Biskitman/Olympus-Rover/For Meeting/CAD/Rover_SomePanelsGone.PNG

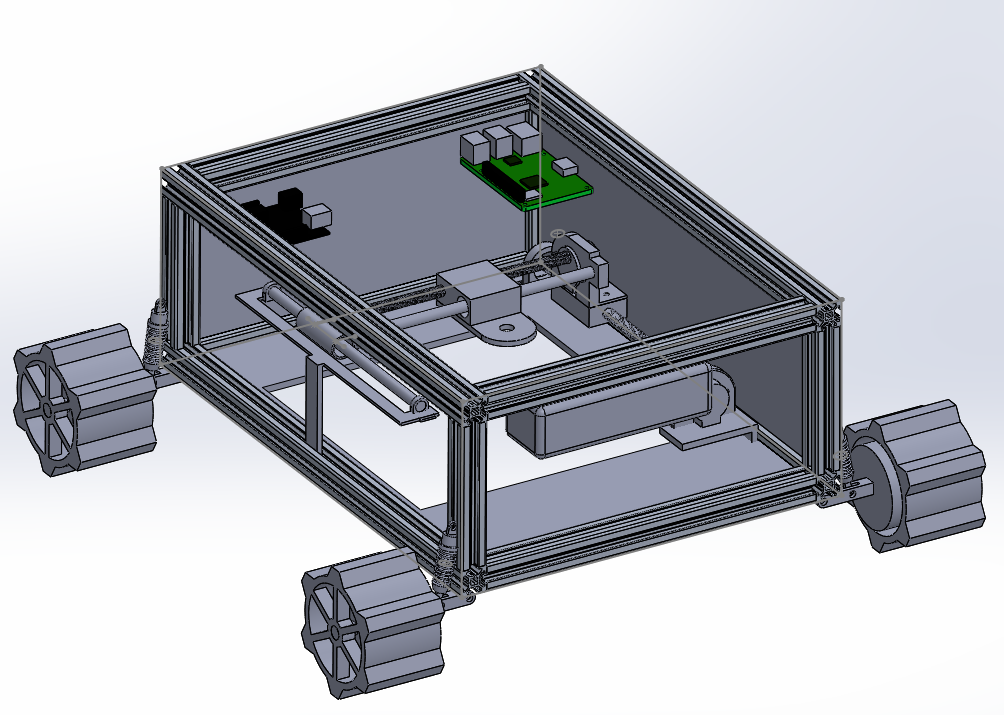
For Meeting/CAD/Rover_SomePanelsGone.PNG
