Biskitman/Olympus-Rover/README.md

# Olympus-Rover
Astro Society - Project Olympus Rover 2020 by UKSEDS
