Biskitman/Olympus-Rover/'Research Work'/Rover Suspension System.docx

Rover suspension system

In order to guarantee the best performances and to avoid any damage to the internal parts or to a hypothetic load, it’s important to design a very good suspension system for the rover. The rover will have 6 wheels and everyone of those will be directly connected to the chassis through a shock absorber. The distance between the shock absorbers will be fixed on one end of the body, whereas, on the other it will be adjustable so that we can set the tracks at the right tension. As we don’t know what the final weight of the whole system will be, we will be using adjustable shock absorbers. That will allow us to modify the length of the springs and consequently the thrust produced following Hooke’s law: F= -kX

Where k is the spring constant which remains the same, and X is the displacement of the spring. As we can see the force produced is proportional to the extension, so, if we modify the last one, we can get the right force for our system (Matt Williams, 2015).

In conclusion these are the shock absorbers, we need 3 sets of them (6 in total): https://www.amazon.co.uk/BQLZR-Purple-108004-RC1-Suspension/dp/B00RSY6G36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

References

Matt Williams (2015) What is Hooke’s Law?. Available at: https://phys.org/news/2015-02-law.html (Accessed: 12 February 2020).
