Biskitman/Olympus-Rover/'Research Work'/Wheels vs Tracks.docx

Wheels vs Tracks

The team looked at different wheel types and methods for motion across all terrains and decided to look at the benefits of using tracks over wheels. The ideal system is reliant on the terrain type, weight, the needed traction, and controllability. Tracks are suitable for soft surfaces due to their lower pressure and for driving over obstacles. They enable greater power efficiency, which is extremely important for the limited power supply that our rover has. On the other hand, wheels have greater simplicity and less moving parts, lighter weight and greater maneuverability (Wheels vs Continuous Tracks: Advantages and Disadvantages 2015).

According to Wheels vs Tracks from the journal of terramechanics, “On a firm sandy (or frictional) soil, the traction of a wheeled vehicle is less dependent on tire contact area. Therefore, the traction of a wheeled vehicle is closer to that of a comparable tracked vehicle on a firm sandy (or frictional) soil than on a clayey (or cohesive) soil.” (J.Y Wong, Wei Huang, 2006), this is important given the terrain details given for the competition being Mars analogue, and clay like.

The power efficiency of wheels vs tracks are also pointed out from the journal, when it’s stated that “the thrust developed by the 8 × 8 wheeled vehicle is 50.4% of that developed by the tracked vehicle. The lower thrust of the 8 × 8 wheeled vehicle, in comparison with the comparable tracked vehicle, is primarily due to the fact that with a much shorter contact length, the shear displacement at the rear of the contact patch of a tire will be much lower than that of a track at the same slip. Since the thrust developed by a vehicle running gear is the integration of the shear stress over the contact area, with lower shear stress and lower contact area, the thrust developed by a wheeled vehicle will generally be lower than that developed by a comparable tracked vehicle.” (J.Y Wong, Wei Huang, 2006) This is important given the limited power supply in our design, and as a result efficiency is of great importance.

The team has decided that with our design, a few key things are important with movement, efficiency, controllability and the ability to climb over obstacles. It is for this reason that we’ve concluded that the pros of using continuous tracks outweigh the cons given the requirements and limitations.

References

i. J.Y Wong, Wei Huang, (2006) ‘Wheels vs. tracks – A fundamental evaluation from the traction perspective’, Journal of Terramechanics (https://www-sciencedirect-com.ezproxy.kingston.ac.uk/science/journal/00224898), 43,1, pp. 27-43, Available at: https://www-sciencedirect-com.ezproxy.kingston.ac.uk/science/article/pii/S0022489804000886#bib2 (Accessed: 9th February 2020)
ii. Wheels vs Continuous Tracks: Advantages and Disadvantages (2015) Available at: https://www.intorobotics.com/wheels-vs-continuous-tracks-advantages-disadvantages/ (Accessed: 12th February 2020)
