Biskitman/Olympus-Rover/Reports/CDR/scedule.xlsx

Sheet: Planned CDR Schedule
 |  | PDR due 20th |  |  |  |  |  |  |  |  |  | CDR due 1st
 | Date | DEC 16th | DEC 23rd | DEC 30th | JAN 6th | JAN 13th | JAN 20th | JAN 27th *** | FEB 3rd | FEB 10th | FEB 17th **** | FEB 24th ** | MAR 2nd | MAR 9th | MAR 16th | MAR 23rd | MAR 30th
Person
Iras |  |  | HOLIDAY |  |  |  | Seek Funding & University Materials |  | Find and compile part spreadsheet of Parts to Buy |  | Write CDR |  | TO BE SCHEDULED
Erika |  |  |  |  |  |  | Risk assesment & Lab application |  |  | Create Post-CDR Schedule
Nikolo |  |  |  |  |  |  | Researching & Choosing Materials & Processes to Use |  |  | Basic Prototyping |  | Help CDR
Bertie |  |  |  |  |  |  | Engineering Drawing & 3D Modelling |  |  |  | Help CDR
Sam |  |  |  |  |  |  | Research & Choose Electronics to Use |  | Power Calculations | Circuit Diagrams & Basic Prototypes if Possible |  | Help CDR
Emily |  |  |  |  |  |  |  |  | Choose Languages/Platforms & do Initial Code Plan |  |  | Help CDR
The roles we had allocated from the beginning of the project lent itself well into dividing the team into pairs to work on 3 categories of tasks together: Design (Bertie & Nikolo), Admin (Iras & Erika) and Electronics (Sam & Emily) tasks. We had a rough week-by-week schedule of tasks for each person, up to the CDR submission date, and had planned to make a new schedule for after the CDR up to the Readiness Review, however, due to disruptions in the team, this did not happen.
1. For the last week before the CDR submission deadline, everyone was intended to work on the CDR as a sort of mitigation to ensure that the CDR is definitely complete on time, in case the workload of writing the CDR was too difficult for just two people and the CDR needed extra work. We do admit that this was not enough time dedicated to margin/mitigation time, as many things did go wrong and we did not complete all that we intended to before the CDR submission date and therefore have included much more margin time in our post-CDR schedule as a result.
2. Erika drops out |  |  | 3. By this time, members who hadn't held up to their roles either willfully left the team or were kicked out. This was decided to be the best course of action as we could make a new schedule around reliable members of the team only, giving us a reduced risk of delays in the future. However, with only two real team members remaining and most tasks being incomplete, we had to prioritise tasks dependant on how urgantly they needed to be completed and so focussed our attention on the CDR and all tasks crucial to the CDR submission. Unfortunately due to this constraint, we have decided to postpone the following tasks to be completed after the CDR submission: Aquiring funding & university funding, 3D modelling, Prototyping and Completing full risk assesments & lab packs to gain access to university manufacturing facilities.

Sheet: Planned Post-CDR Schedule
 |  | CDR due 1st |  |  |  |  |  |  | CDR Interview 14th |  |  |  |  |  |  | TRR due 1st
 |  | Date | MAR 2nd | MAR 9th | MAR 16th | MAR 23rd | MAR 30th | APR 6th | APR 13th | APR 20th | APR 27th | MAY 4th | MAY 11th | MAY 18th | MAY 25th | JUN 1st | JUN 8th | JUN 15th | JUN 29th | JUL 6th | JUL 13TH | JUL 20th | JUL 27th | APR 3rd
Task # | Task Name
1.00 | ADMIN TASKS
1.10 | Organise Funding
1.11 | Write up official description + part list
1.12 | Start a KU backer campaign
1.13 | Contact student union about funding
1.14 | Talk to society treasurer about using a portion of monthly society funds
1.15 | Contact possible investors
1.20 | Procure materials/parts
1.21 | Request spare available materials from construction labs
1.22 | Order parts from uni suppliers through lab technicians
1.23 | Order rest of parts privately to project leaders house
1.24 | Receive all parts and reorder/refund any that do not arrive on time
1.30 | Access construction facillities
1.31 | Perform a risk assesment
1.32 | Ensure all members have completed compulsory saftey training
1.33 | Organise dates to use construction labs
1.40 | Prepare for readiness review
1.41 | Film progress video
1.42 | Keep logbook of progress
2.00 | MANUFACTURING TASKS
2.10 | 3D Modelling parts
2.11 | Chassis
2.12 | Crane system
2.13 | Tracks
2.14 | Suspension
2.15 | Vibration plate interface
2.16 | Electronics
2.17 | Compile all together
2.20 | Constructing
2.21 | Chassis
2.22 | Crane system
2.23 | Tracks
2.24 | Suspension
2.25 | Vibration plate interface
2.26 | Electronics
2.27 | Compile all together + tweak
3.00 | PROGRAMMING / ELECTRONICS
4.00 | TESTING

Sheet: Trade-Offs
Trade-Offs
 | Ease to Implement | Weight | Price Effectiveness | Weight | Durability | Weight | Time Effectiveness | Weight | Weather Resistance | Weight | Grip | Weight | Total
Wheels
Tracks
Legs
Omniwheels
 | Ease to Implement | Weight | Price Effectiveness | Weight | Durability | Weight | Time Effectiveness | Weight | Reliability | Weight | Total
Bought Suspension
Custom Design
Springs
None
 | Ease to Implement | Weight | Price Effectiveness | Weight | Reliability | Weight | Time Effectiveness | Weight | Range | Weight | Speed | Weight | Bandwidth | Weight | Total
Radio
Bluetooth
Wifi
 | Ease to Implement | Weight | Price Effectiveness | Weight | Durability | Weight | Time Effectiveness | Weight | Reliability | Weight | Total
Dual Axis Crane
Robot Arm
Scoop

Sheet: Sheet5
 |  | Selection Criteria - Movement System
 | Weight % | Wheels (Reference) | Weighted | Tracks | Weighted | Legs | Weighted | Omniwheels | Weighted
Ease to Implement | 15 | 3 | 0.45 | 2 | 0.3 | 1 | 0.15 | 1 | 0.15
Price | 10 | 3 | 0.3 | 2 | 0.2 | 3 | 0.3 | 1 | 0.1
Durability | 25 | 3 | 0.75 | 2 | 0.5 | 2 | 0.5 | 2 | 0.5
Time Effectiveness | 10 | 3 | 0.3 | 2 | 0.2 | 3 | 0.3 | 2 | 0.2
Environment Resistance | 20 | 3 | 0.6 | 4 | 0.8 | 4 | 0.8 | 2 | 0.4
Grip | 20 | 3 | 0.6 | 5 | 1 | 1 | 0.2 | 2 | 0.4
Total Weighting | 100
Total Score |  | 3 |  | 3 |  | 2.25 |  | 1.75
Rank |  | First |  | First |  | Second |  | Third
Continue? |  | Consider |  | Consider |  | No |  | No
 |  | Selection Criteria - Suspension
 | Weight % | Bought Suspension (Ref) | Weighted | Custom Design | Weighted | Springs | Weighted
Ease to Implement | 10 | 3 | 0.3 | 1 | 0.1 | 3 | 0.3
Price | 5 | 3 | 0.15 | 3 | 0.15 | 4 | 0.2
Durability | 15 | 3 | 0.45 | 2 | 0.3 | 4 | 0.6
Time Effectiveness | 5 | 3 | 0.15 | 1 | 0.05 | 2 | 0.1
Reliability | 25 | 3 | 0.75 | 2 | 0.5 | 2 | 0.5
Shock Absorbtion | 40 | 3 | 1.2 | 2 | 0.8 | 2 | 0.8
Total Weighting | 100
Total Score |  | 3 |  | 1.9 |  | 2.5
Rank |  | First |  | Third |  | Second
Continue? |  | Yes |  | No |  | No
 |  | Selection Criteria - Communication
 | Weight % | Radio (Ref) | Weighted | Wifi | Weighted | Bluetooth | Weighted
Ease to Implement | 10 | 3 | 0.3 | 4 | 0.4 | 4 | 0.4
Price | 10 | 3 | 0.3 | 5 | 0.5 | 5 | 0.5
Reliability | 25 | 3 | 0.75 | 4 | 1 | 3 | 0.75
Time Effectiveness | 5 | 3 | 0.15 | 4 | 0.2 | 5 | 0.25
Range | 20 | 3 | 0.6 | 3 | 0.6 | 2 | 0.4
Speed | 15 | 3 | 0.45 | 4 | 0.6 | 2 | 0.3
Bandwidth | 15 | 3 | 0.45 | 5 | 0.75 | 3 | 0.45
Total Weighting | 100
Total Score |  | 3 |  | 4.05 |  | 3.05
Rank |  | Third |  | First |  | Second
Continue? |  | No |  | Yes |  | As a backup system
 |  | Selection Criteria - Method of Pickup
 | Weight % | Robot Arm (Ref) | Weighted | Dual Axis Crane | Weighted | Scoop | Weighted
Ease to Implement | 10 | 3 | 0.3 | 1 | 0.1 | 4 | 0.4
Price | 5 | 3 | 0.15 | 3 | 0.15 | 4 | 0.2
Durability | 15 | 3 | 0.45 | 4 | 0.6 | 5 | 0.75
Time Effectiveness | 5 | 3 | 0.15 | 3 | 0.15 | 4 | 0.2
Reliability | 25 | 3 | 0.75 | 4 | 1 | 2 | 0.5
Precision | 40 | 3 | 1.2 | 5 | 2 | 1 | 0.4
Total Weighting | 100
Total Score |  | 3 |  | 4 |  | 2.45
Rank |  | Second |  | First |  | Third
Continue? |  | No |  | Yes |  | No
