Biskitman/Olympus-Rover/For Meeting/CAD/Crane.PNG

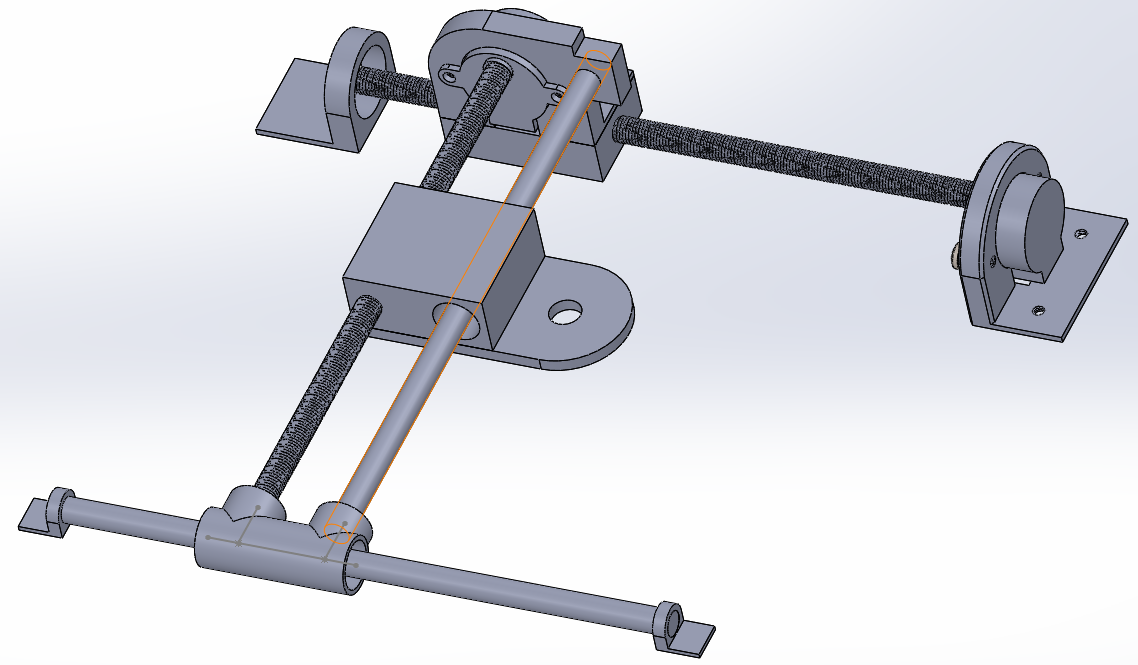
For Meeting/CAD/Crane.PNG
