Biskitman/Olympus-Rover/For Meeting/CAD/Rover_AllPanels.PNG

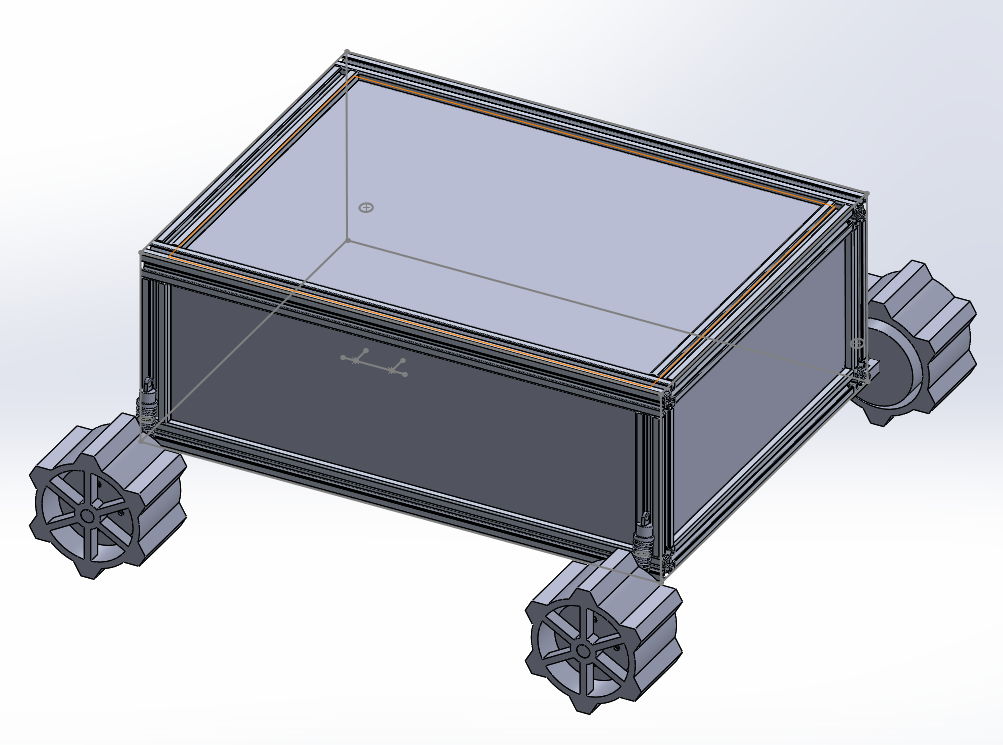
For Meeting/CAD/Rover_AllPanels.PNG
