Biskitman/Olympus-Rover/For Meeting/CAD/Rover_Open.PNG

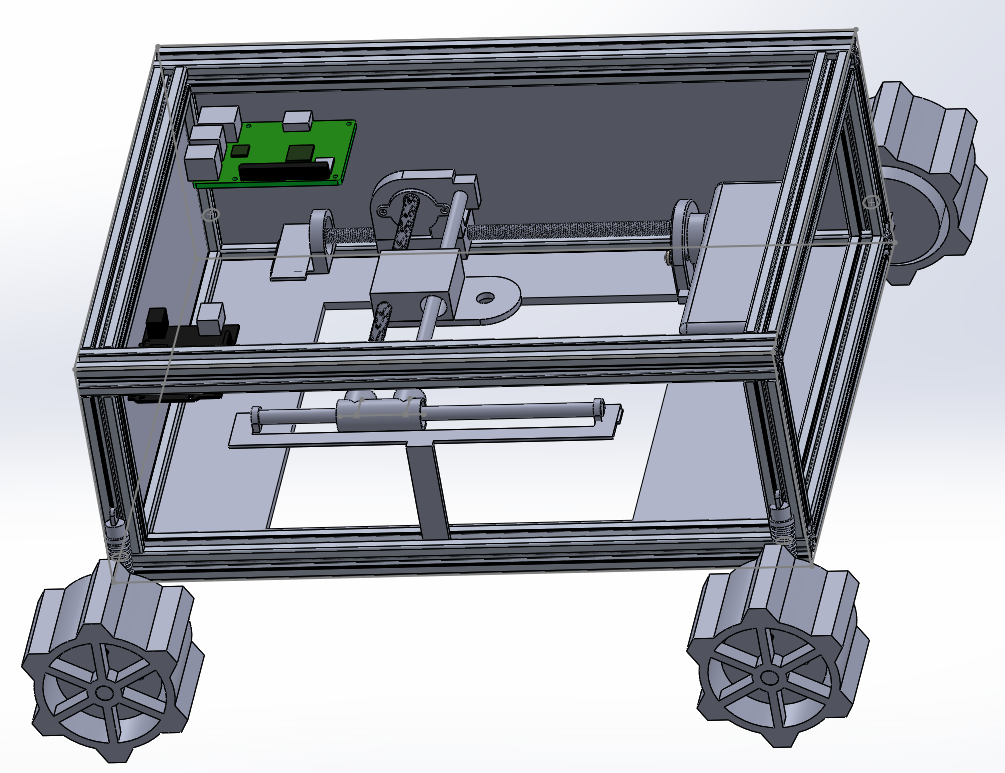
For Meeting/CAD/Rover_Open.PNG
