Biskitman/Olympus-Rover/For Meeting/CAD/Rover_Top_Off.PNG

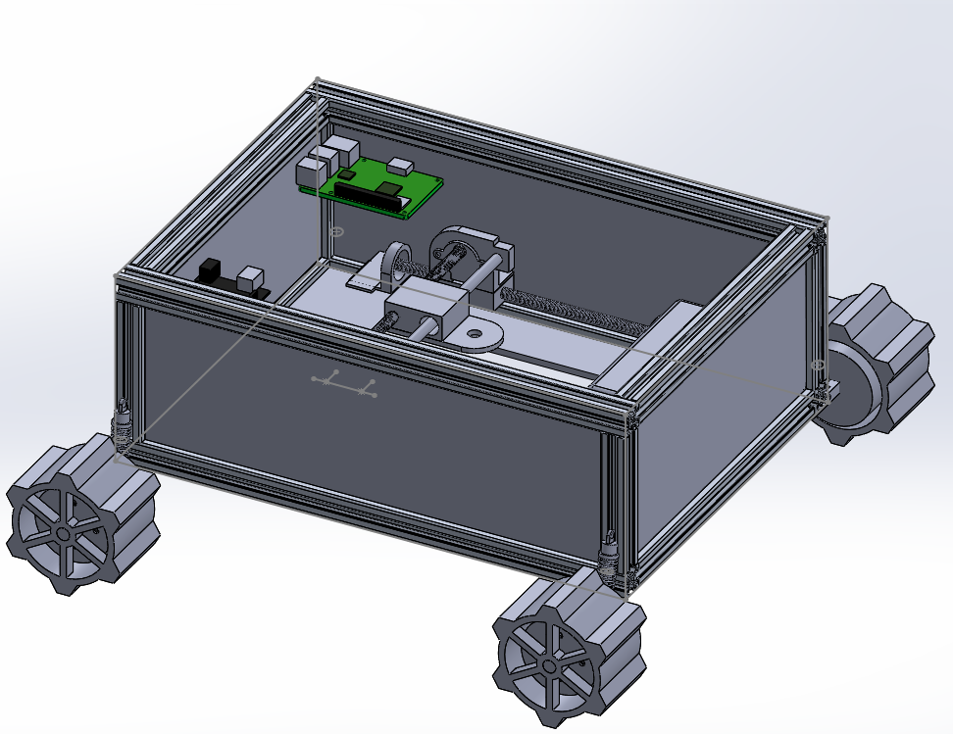
For Meeting/CAD/Rover_Top_Off.PNG
