Biskitman/Olympus-Rover/For Meeting/CAD/Vibration_Interface.PNG

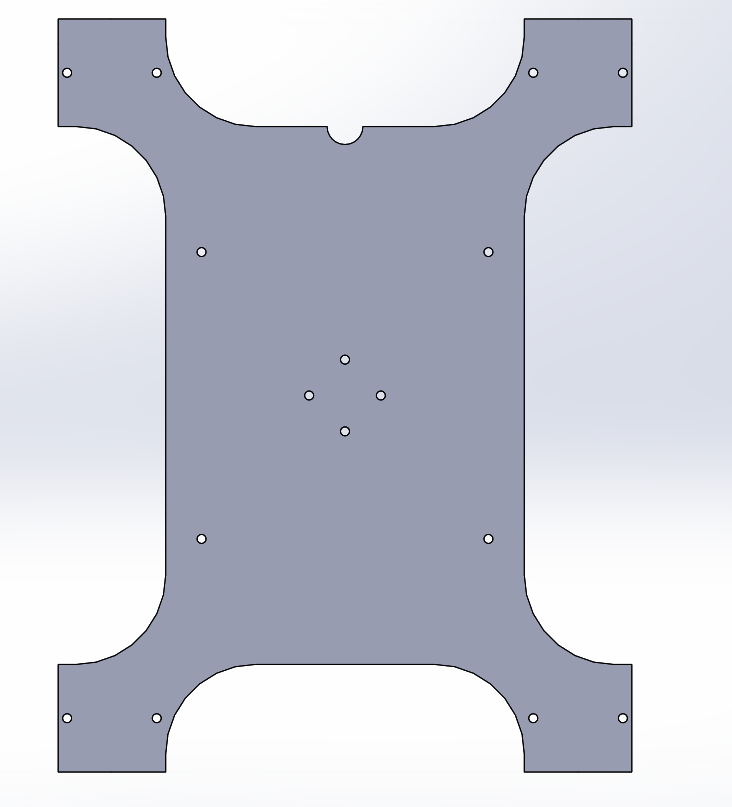
For Meeting/CAD/Vibration_Interface.PNG
