Biskitman/Olympus-Rover/Pictures/Caterpiller Tracks.png

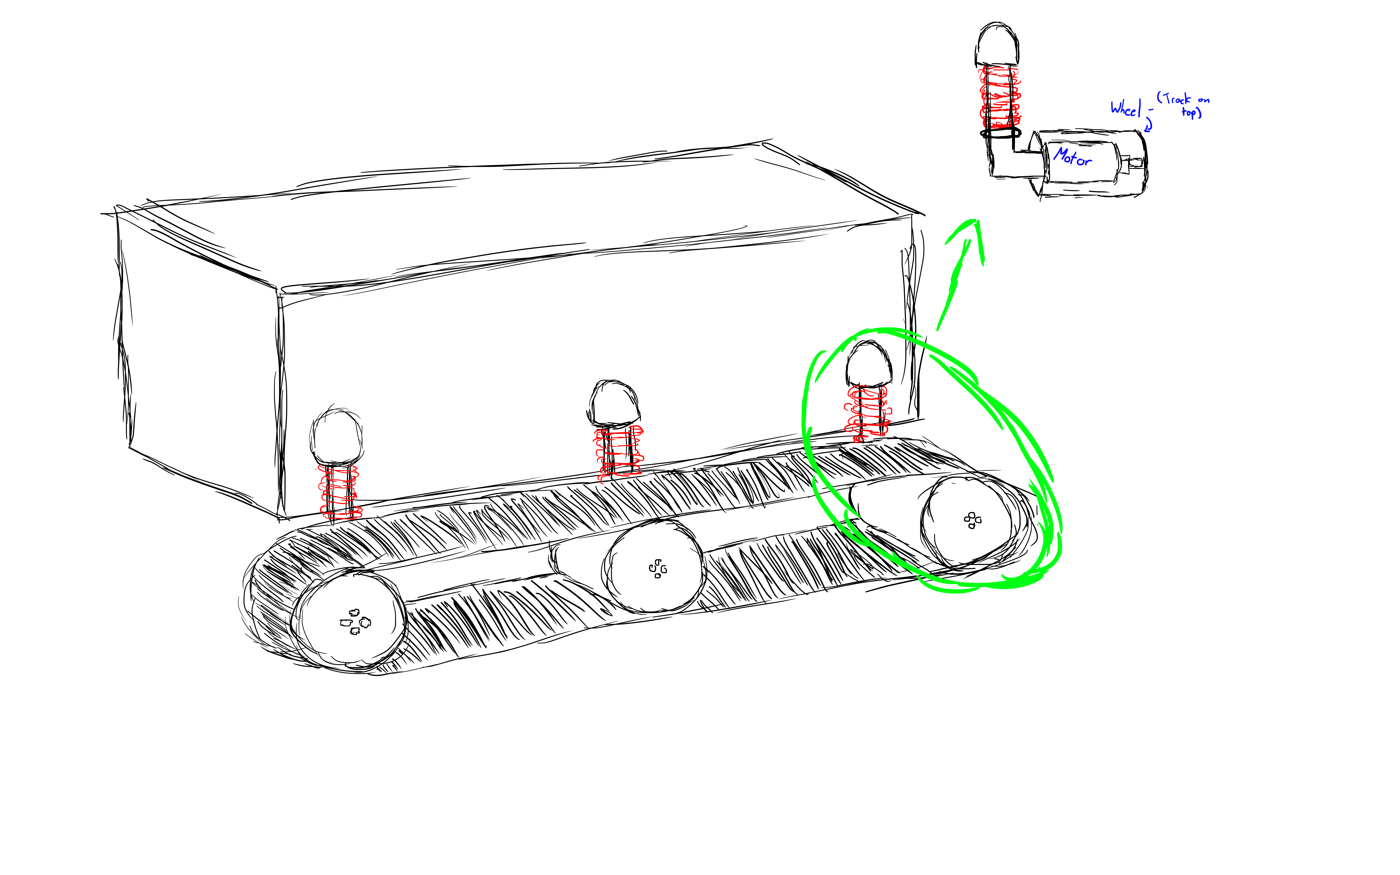
Pictures/Caterpiller Tracks.png
