Biskitman/Olympus-Rover/Pictures/Rover Overview (OG).png

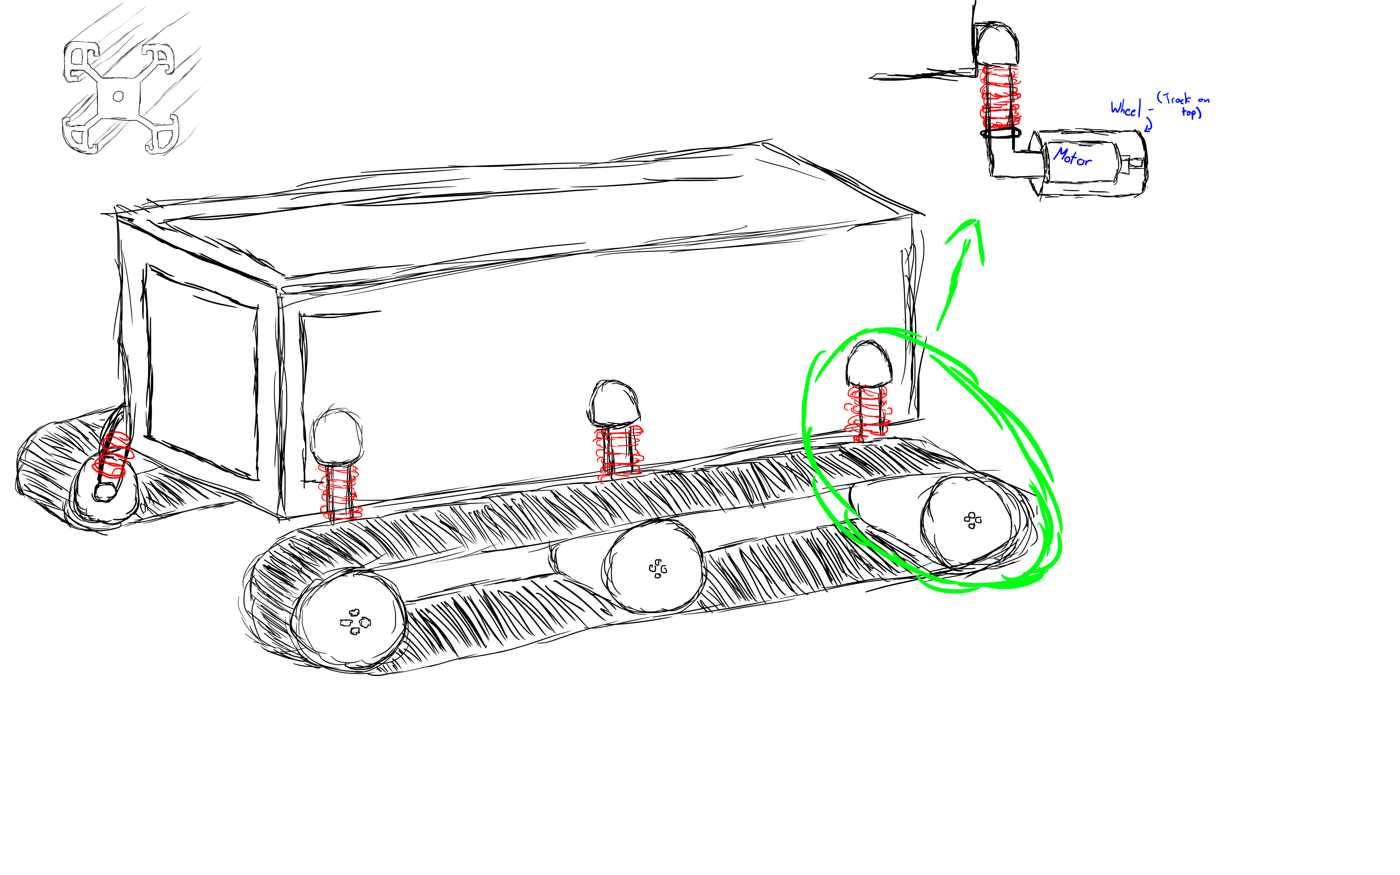
Pictures/Rover Overview (OG).png
