Biskitman/Olympus-Rover/Pictures/Suspension.PNG

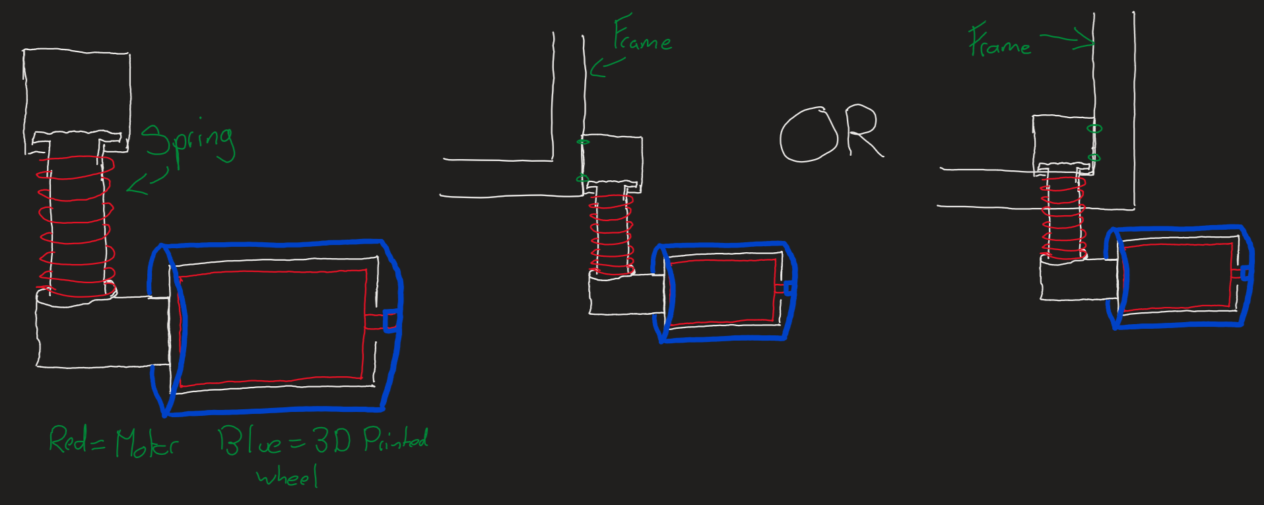
Pictures/Suspension.PNG
