Biskitman/Olympus-Rover/Pictures/Top Down, Electronics.png

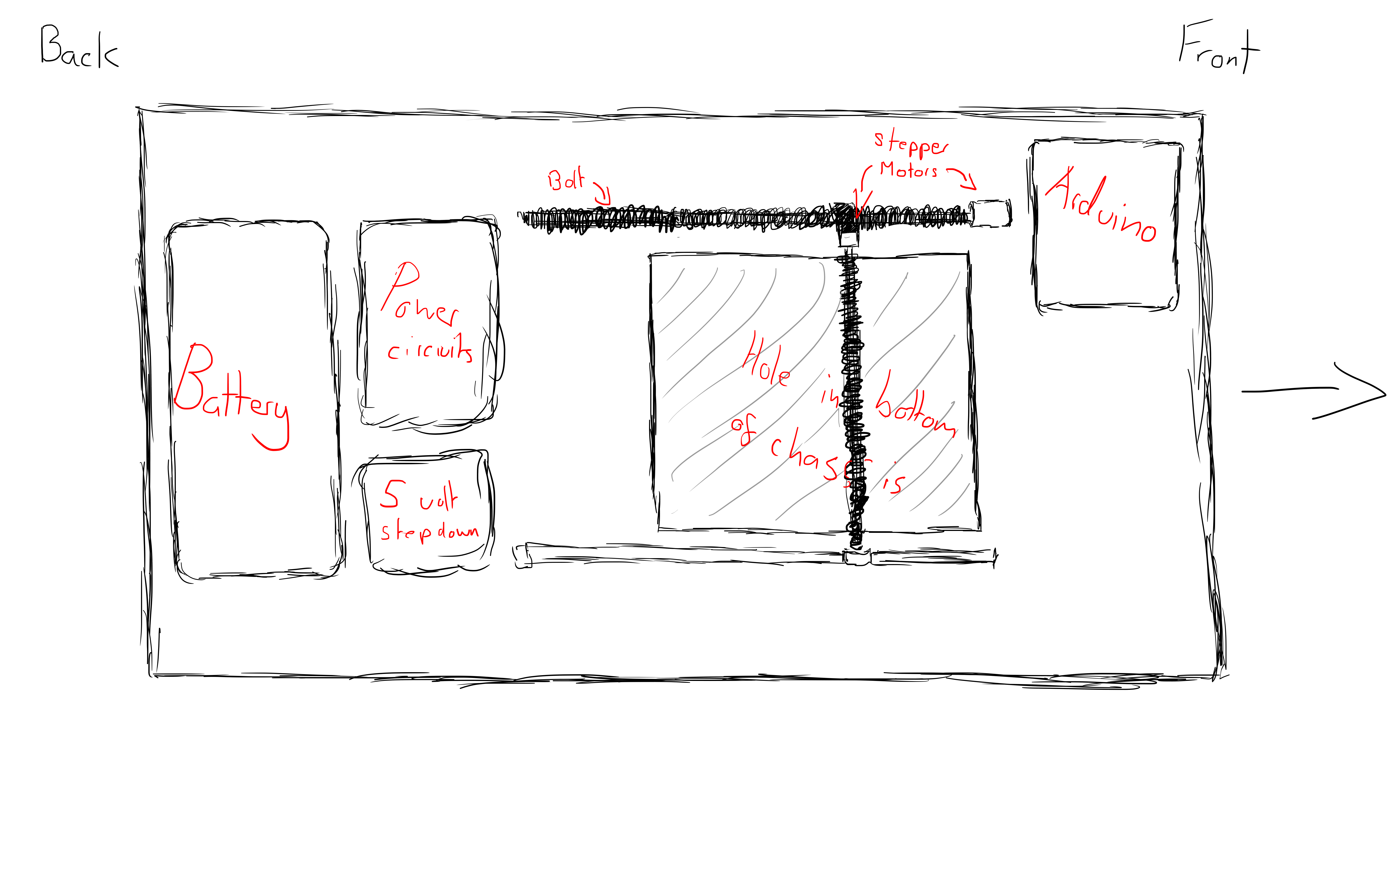
Pictures/Top Down, Electronics.png
