Biskitman/Olympus-Rover/Reports/CDR/Rover part list.xlsx

Sheet: Sheet1
Part | Price | Amount Needed | Total | Link | Purpose & Justification
Raspberry Pi 4 (4GB model B) | £54.00 | 1 | £54.00 | https://thepihut.com/products/raspberry-pi-4-model-b?variant=20064052740158&src=raspberrypi | The Raspberry Pi 4 is the latest and most powerful raspberry pi with integrated wifi. This model will be powerful enough to manage the networking and machine learning we would like to integrate onto the rover, and is capable of running high
Arduino Nano 33 BLE Module | £21.06 | 1 | £21.06 | https://uk.rs-online.com/web/p/processor-microcontroller-development-kits/1927587/ | The small form factor and 9-axis intertial sensor on this board is perfect for our project as we have limited space and will need the rover to remain stable. It still has all the pins of a regular-sized arduino and does not require a wifi module as this will be handled by the raspberry pi.
Small breadboards (option 1) | £5.99 | 2 | £11.98 | https://www.amazon.co.uk/ELEGOO-tie-points-Breadboard-Breadboards-Electronic/dp/B01N0YWIR7 | Space is very limited in this project and we do not require many pins for the extra coponents that will need to connect to the arduino. The size of these also allow us to adjust the spacing of the electronics around the other parts of the rover where position is more fixed. One breadboard will be used for the motors, and one for the sensors. (In the final rover we can solder the components but for prototyping, the breadboards are more suitable)
Small breadboards (option 2) | £5.15 | 2 | £10.30 | https://uk.rs-online.com/web/p/breadboards/6348875/ | Thin version from RS components, for advantages, see above.
Jumper wires | £5.95 | 1 | £5.95 | https://www.amazon.co.uk/Elegoo-120pcs-Multicolored-Breadboard-arduino-colorful/dp/B01EV70C78 | Good variety of different wires to use for attatching components within the prototype.
Battery | £49.99 | 1 | £49.99 | https://www.amazon.co.uk/FCONEGY-11-1V-5500mah-Battery-Deans/dp/B07PHST8C3
Motors | £7.99 | 4 | £31.96 | https://www.amazon.co.uk/EsportsMJJ-Teeth-Electric-Motor-Bosch/dp/B075CN3MDL?s=home-garden
Stepper Motors | £11.58 | 1 | £11.58 | https://www.amazon.co.uk/Kuman-Stepper-arduino-28BYJ-48-Breadboard/dp/B01IP7IOGQ
Tracks | £11.13 | 1 | £11.13 | https://www.amazon.co.uk/Baosity-Plastic-Removable-Tracked-Chassis/dp/B07R4GQ32N
Suspension systems |  |  | £0.00
Cameras | £24.00 | 2 | £48.00 | https://thepihut.com/products/raspberry-pi-camera-module?src=raspberrypi | Only raspberry pi camera module suitable for livestreaming over wifi due to fast operation and 1080p quality at 30hz with an 8megapixel sensor. Has official raspberry pi camera ribbon connector and support in raspbian, making it easy to use and program with.
ultrasonic sensors | £8.99 | 3 | £26.97 | https://www.amazon.co.uk/ELEGOO-Ultrasonic-Raspberry-Datasheet-Available/dp/B01M0QL1F1
Claw | £13.39 | 1 | £13.39 | https://www.aliexpress.com/item/32860356446.html?spm=a2g0o.productlist.0.0.53a45679fCa5el
Total | £219.22 |  | £296.31
Weights | Max
Battery | 1kg
Motors | 1 for 250, max weight 1kg
pi + ardu | 60g
tank treads | unlisted, negligable
aluminium extrusion | 20 x 20, 0.5kg per m | 1kg

Sheet: Sheet2
 | Weeks | March 2th - 8th | 9th - 15th | 16th - 22nd | 23rd - 29th | 30th - April 5th | 6th - 12th | 13th - 19th | 20th - 26th | 27th - May 3rd | 4th - 10th | 11th - 17th | 18th - 24th | 25th - 31st | June 1st - 7th | 8th - 14th | 15th - 21st | 29th - July 5th
Key Dates |  |  |  |  |  | March 31st RID & presentation |  |  |  | May - Close outstanding RIDs |  |  |  |  | June - TRR & Video
Activity
Raise Funds
Order & Test Parts
Reorder Faulty parts
Planning code/ modeling
Construction
Physical/Durability Testing
Programming
Program/Movement Testing
Training/Further Testing
Calibration/Tweaking
Preparing For RID
Preperation of TRR
Final Prep for Event
Key
Admin Activities
Production
Testing
Mitigation Time
