Biskitman/Olympus-Rover/Reports/CDR/Final Submission/Team Ares RIDs Feedback 2019_2020.xlsx

Sheet: RID Marksheet
RID# Reference | Document | Page, § | RID Subject | Question/Remark | Reviewer Suggested Solutions | Major/Minor | Team Answers | Action/Comment | Responsible | Action Due Date
Summary |  |  |  | There is not enough detail provided in the CDR document overall and a severe lack of mechanical design maturity. Some good ideas have been suggested but they have not been expanded upon appropriately for a CDR level. With the current information provided it is not possible to tell if the rover has been designed sensibly or not. | By CDR meeting I would expect a significant amount of extra work to have been completed including: - detailed design trade-offs - detailed CAD drawings of all critical areas - CAD drawing of overall rover showing all interfaces and key components - detailed drawing of vibration plate interface - Power budget with calculations - Calculation for number of motors required
CJ-01 | CDR submission | 2 | Introductory Statement | Introduction ends mid sentence. | Please complete the Introduction. PLEASE proof read your work before submitting. | Minor | Fixed | We did include a document with the full sentence in the google drive as we caught this error a few minutes after submitting, however we have now proof read the CDR and this is no longer an issue for the introduction. | Bertie | 2020-04-08
CJ-02 | CDR submission | 4 | Schedule | Schedule only covers period after CDR. | The schedule should be an update of the PDR schedule showing your progress through the tasks that were identified at that time. A schedule is used to track the progress through the whole project from start to finish. | Minor | We will fix this by including a schedule showing our progress from PDR to CDR
CJ-03 | CDR submission | 4 | Schedule | Schedule is very ambitious | It is mentioned that the detailed design is not yet started. At CDR we would expect an almost completed design that will only need very minor tweaks to complete. | Major | We have rushed to get an almost complete design in time for the meeting | We are producing a more detailed design with CAD models. There may be small errors in these models however, but we can rectify this quite easily. | Bertie
CJ-04 | CDR submission | 4 | Schedule | Margin in schedule | You note that you may need to increase the length of some tasks if you encounter delays. Is this accounted for with the 'Mitigation time'? | Minor | Yes, mitigation time was to account for delays of any tasks, however due to corona virus, we will be redoing the schedule and adding more mitigation time in case of a change of competition day or something similar | Due to CJ-02, we will include an updated/new schedule explaining Mitigation time and extra margin if tasks werent/arent complete on time. | Bertie | 2020-04-08
CJ-05 | CDR submission | 6 | Requirements | Some duplication of requirements and lack of clarity | You have two effectively identical requirements on static stability. Additionally some requirements are a little vague, a good requirement is easily quantifiable and/or testable without the need for human interpretation. Eg: "Be able to operate under sub-optimal conditions such as rain" what other 'sub-optimal' conditions are you considering? Either list them all or just say able to operate in rain Another example: "Accurately pick up the sample, preferably without dropping it". How accurately? this should be quantified, is 1mm error accurate enough? 1cm? 1nm? Also the word 'preferably' should never be used in a requirement. In business requirements are things that your product is contractually required to do by the customer in order to get paid. Either it must do the thing, or it must not (or it must do the thing correctly a certain proportion of time, eg drop things less than 10% of the time). | Minor | Fixed, requirements are not duplicated and are easily quantifiable | May need some more refinement, but removed the duplicate. | Bertie | 2020-04-08
CJ-06 | CDR submission | 6 | Requirements | Use of 'goal' requirements | In this context these are fine, they identify performances you would like to achieve but that may not be possible in the current scope. However, be aware that in industry they are effectively pointless most of the time. The customer has already identified what they want you do (core requirements), everything extra is just a cost to you against a product you have already sold. Sometimes you may wish to deliver extra quality to acquire future business, however, in most requirements defined industries (like the space industry) this would be pre-agreed with the customer and added to the core requirements. | Minor | We have added a statement to show that we are only including these goals in this specific context. | We understand how these extra goals would, in the real world, be an extra cost which the customer has not asked for. Therefore, we are only including it in this competition, as if we had more time or a bigger team, we could have turned the extra goals into requirements. We can remove these goals if it is not appropriate.
CJ-07 | CDR submission | 7 | Trade-Offs | Lack of Trade-Offs. Team don't appear to understand what an engineering trade off is. | Saying that "There are not many trade-offs we have had to make so far in designing our rover" just means you haven't thought about your design properly. You have selected some design aspects: wheels vs track, type of suspension, CPU to use, etc. etc. etc. How do you know if any of these were the correct choice? Did you just guess? Did you just pick one at random and hope for the best? You must have done some research? You should have looked at specifications and performances, compared them with rival products and then selected one or the other. That is a trade off, this section should include a formalised version of the trade-off you made in your head. PLEASE come to the CDR meeting with at least one example of a numerical trade off for one aspect of your design | Major | We have completed some numerical trade off's of various aspects of our design using the W&R method. We still need to amend our CDR by explaining and including our research however. | The numerical trade-offs did show us that some choices we made were not the best and we are now ammending the design to reflect this. | Emily
CJ-08 | CDR submission | 7 | Risk Register | It would be nice to see a risk register here | Typically any discussion of Risk is accompanied by a risk register, or risk matrix where the severity of each risk is matched against its likelihood of occurring. This allows identification of items that are the biggest risks. Eg, you have 3 risks which each rank 1-5 in terms of severity and likelihood: 1) spontaneous combustion, severity 5, likelihood 1, total of 5 2) Wheel failure, severity 4, likelihood 3, total of 12 3) Small wheel slip, severity 2, likelihood 4, total of 8 Now you can identify the most critical areas for risk management | Minor | We will complete a full risk analysis of every component of our rover in order to identify areas that might need more attention and management
CJ-09 | CDR submission | 10 | Mechanical Design Maturity | There is a severe lack of mechanical design maturity, only a generic chassis has been presented with a rough sketch of where components will go. | Detailed CAD drawings should be provided at CDR stage with only minor tweaks needed to complete the design. Almost no detail has been shown in any aspect of the design. This is extremely concerning and leaves the team with a huge workload in order to complete the project in time for the competition. As such with this information missing, CDR Primary Objective 3 is failed. PLEASE correct this before the CDR meeting. | Major | We will rectify this with as many CAD drawings as we can complete in the 8 days from receiving the RID to the meeting.
CJ-10 | CDR submission | 10 | Vibration Interface | No drawing of how the chassis will be mounted | There is only a very rough description of how you plan to be able to mount to the interface plates with no drawing showing that it will actually be possible and no design of any interface brackets. With no detail in the design either it is impossible to tell if any other components will interfere with the mounting to the vibration table. As such with this information missing, CDR Primary Objective 2 is failed. PLEASE correct this before the CDR meeting. | Major | We will design and make a CAD model of a mounting interface between our rover and the vibration table. It will be screwed to the vibration table in 8 places and have platforms for each wheel, which will have a ziptype securing the wheel to the interface plate |  | Bertie | 2020-04-13
CJ-11 | CDR submission | Throughout | Design by testing | The description of most of the planned activities suggests you intend to do almost all of the design by guessing the best configuration and then testing and correcting if an area fails. | This is an extremely costly and time consuming approach, you will need multiple runs of tests and potentially need to order or make new parts to replace those that don’t work. A detailed design with calculations to work out what is needed would resolve this and this is what is expected at the CDR stage. If you weren't able to provide the detailed design for whatever reason I would instead expect to see extensive test results from prototype tests that indicate what the final design should be. Given that neither of these have been completed the design does not meet the CDR level of maturity | Major | Through rectifying other Major issues in this RID, we will have a detailed design with calculations to resolve this. We had issues with our original way of funding, but have now set up a Kubacker post where we intend to get funding for both a prototype platform, which we can then turn into the final rover. | We have a KUBacker post ready to go, After reviewing similar enigneering projects on KUBacker, we are confident we can get the funding we need over the next few weeks. Our more detailed design should also make up slightly for the lack of prototyping we were not able to achieve. | Bertie
CJ-12 | CDR submission | 12 | Suspension design | Designing your own suspension system is high risk and also not the focus of this project. If you were really going to do this I would expect to see a fully designed system at CDR with tests and prototypes to prove that it is suitable for the rest of the rover | The suspension system is clearly not ready to be considered for use on the rover and will eat up a huge amount of time to get right. Time which you will need to complete your design in areas where off the shelf alternatives are not available. I highly recommend buying suspension instead of trying to design a system from scratch at this late stage | Major | As we already planned a backup in case manufacturing our own suspension was too difficult, we can use the shock absorbers that we can buy, which we have shown in our CDR. | We will incorporate the shock absorbers shown in our CDR into the rover design and make sure they can interface properly with our wheels. | Bertie
CJ-13 | CDR submission | 14 and throughout | Crane design | It is very hard to see the detail in the hand drawn diagram or see how it attaches to the rest of the rover. Additionally a hand drawing cannot easily be changed into a manufacturable part or design. | A CAD drawing would show the design much much better, would show how it attaches to the rover, it would show if you had any interference issues with other parts AND it would actually allow you to manufacture parts from the drawing directly. I would not expect to see hand drawings in a CDR design document (or even really at all in any document except perhaps very early stage conceptual work). As the name suggests the Critical Design Review is supposed to allow the reviewer to asses the critical design aspects. A hand sketch doesn't show any design aspects at all except for a rough idea and therefore is not acceptable. | Major | We will provide CAD models of this design, which should provide a better idea of the crane system. | We have modelled the exact stepper motors we are planning to use and the system we plan to assemble. We may have trouble during manufacturing however, as from a little experience with 3D printing, it can be quite difficult to get working first time and with ease. | Bertie
CJ-14 | CDR submission | N/A | User Manual | One of the objectives for the CDR is a release of the user manual detailing rover operation | release document | Minor | We will either have the user manual as a separate document to go with the CDR, or we will insert the user manual into the appendix of the CDR.
CJ-15 | CDR submission | 22 | Power Consumption | There are some assumptions made about a correct battery size however no calculations are made. | You know most of the components that you will be using and have access to their datasheets. I would expect to see a calculation of the peak and average power requirements in order to work out what battery you need. | Minor | We will amend the CDR to show how we came to a calculation for the battery size.
CJ-16 | CDR submission | 22 | Number of motors | Again there are assumptions made about the number of motors needed but this can be calculated easily | You know the worst case angle of terrain, you know the mass of the rover, you know the diameter of the wheels in your track and you know the torque of the motors you have selected. It is also possible to look up a reasonable coefficient of friction with the surface and make an educated estimate of losses in the system. It is therefore possible to calculate how many of the motors you will need to safely drive the rover. | Minor | After doing a more thorough trade off, we have decided to use wheels instead of tracks and to use 4 motors. This is because we will be controlling the rover with tank controls, rather than turning wheels and axels.

Sheet: Requirements
# | Requirement | Description
1.1 | Mass | The integrated rover and sample collection payload shall have a combined mass of 5kg
1.2 | Volume | The rover shall be limited to a boxed volume envelope of 0.03 m^3 There are no specific dimension limits.
1.3 | Vibration Environment | The rover shall be designed to survive the launch vibration environment as specified in appendix D.2. Note on use of adapter plates: Simple spring adapter plates typically lead to low resonant frequencies which would cause large increases in the loads experienced by the rover and as such are not recommended. Complex designs, which would be allowed for space use, are likely to be cost prohibitive. The mass of any adapter plates will be included in the calculation of requirement #1.1.
1.4 | Vibration Test Attachment Mechanism | The rover shall be attached to the vibration system with the interface described in appendix D.3 of the rulebook
1.5 | Static Stability | The integrated rover and sample collection system shall be statically stable in all directions to an angle of at least 30 deg
2.1 | Atmosphere | In fitting with the Mars setting of the competition, the Rover shall use a form of locomotion that does not require a significant atmosphere (i.e. no aircraft
2.2 | Surface | The rover shall be able to traverse an unknown surface of sand and rocks (a description of material conditions is available in C.7.1). Rock dimensions range from a vertical height of between 5 to 40cm, with a nominal diameter range of 5 to 25cm. The rock distribution should be considered random. The maximum incline of the slope is 30 degrees,
2.3 | Travel Distance | The expected distance of travel that the rover will have to cover during the test is 30m. Adding a safety margin to this value is recommended
3.1 | Primary Communication | Communication between the operating base and the rover shall be wireless (refer to the range in the test pit specification). No time delay is added to the communication system.
3.2 | Backup Communication | An alternative communications capability shall be included. This may be wired (e.g. Ethernet) and will only be use if unpredictable external factors influence the testing (such as interference). A 100m Ethernet cable will be available for use on the day.
3.3 | Legality | All Wireless communications must use UK legal frequencies, and should be used responsibly.
3.4 | Equipment Placement | RF Equipment may be placed at the landing site (location of the rover start).
3.5 | Line of Sight and Sensing | There will be partial visual line of sight to the rover during the test (from the position of the landing site). the rover should be able to detect and view its surroundings.
4.1 | Live Voltage | No exposed point or area of the vehicle should carry a live voltage > 12V at any point during operation for the rover.
4.2 | Battery | The vehicles batteries should be protected from the following conditions - over voltage, under voltage, over current, over temperature, short circuit and reverse connection. Lead Acid batteries are not allowed. The batteries shall be removable. Battery good practice should be followed (check out the Resources page of the competition website). In the case of LiPo batteries, charge bags and a CE marked LiPo charger shall be used.
4.3 | Kill Switch | The rover shall have an external and easily accessible manual hardware kill switch that isolates battery power from the rest of the rover.
4.4 | Declaration of Autonomy | Rovers with autonomous capabilities shall be highlighted to the judges to ensure that sufficient safety measures are in place.

Sheet: CDR Objectives and Suggestions
 | CDR Primary Objectives
1 | Assess the qualification and validation status of the critical processes and their readiness for deployment for Phase D
2 | Confirm compatibility with external interfaces
3 | Release the final design
4 | Release assembly, integration and test planning
5 | Release flight hardware/software manufacturing, assembly and testing
6 | Release of user Manual
 | RID Subject Suggestions
1 | Are the system budget estimates used suitable and have enough detail (for Phase D)
2 | Project management's communication and work structure of project
3 | Rover verification method/approach
4 | Level of detail and clarity of the dentification & mitigation of risks
5 | How flexible is their prototype for design change after CDR feedback?

Sheet: RID Marksheet Example
RID# Reference | Document | Page, § | RID Subject | Question/Remark | Reviewer Suggested Solutions | Major/Minor | Team Answers | Action/Comment | Responsible | Action Due Date
Summary |  |  |  | In general, a good document, building well on last years experience. There is only one design point to be discussed (wired comms). However, most clearly missing is a statement of the current status of the build/test; I assume that this will be presented at the CDR; without this it is difficult to determine whether the first CDR objective is met.
DAVS-1 | Bristol SEDS CDR Report | 5 | Missing data on drawing | Some pedantic points for correct drawing: a) The projection doesn't say whether it is 1st or 3rd angle. (3rd angle is more normal than 1st) b) No indication is given of the tolerances of the dimensions; the reader can't be sure what the maximum envelope could be... | Modify the drawing with the additional information | minor
DAVS-2 | Bristol SEDS CDR Report | Throughout | Missing information | Quite a lot of "Error! Reference source not found", e.g. in table of contents, missing info (e.g. in s4 particularly) | Fix | minor
DAVS-3 | Bristol SEDS CDR Report | 1 | Understanding the layout of the document. | Although you've lived with this document for a while, readers should be assumed to be idiots. It would be helpful to have a section in the introduction (often called "scope" of the document) in which you say that the document is broken into per-subsystem sections, each of which presents the design description and the test schedule... | Add material to aid reader understanding. | minor
DAVS-4 | Bristol SEDS CDR Report | s9.2 | Risk management | As per DAVS-5 : These are all risks during final deployment; there are many other risks that can be considered | Recommend to include remaining risks from testing (or test failures, given that it should have happened now) in order to present the actual status of the project now. | major
DAVS-5 | Bristol SEDS CDR Report | s9.1.1, General | Test planning | 1)According to the schedule in 9.1.1, nearly all your subsystem testing should have now been completed. Has it been? 2) If it hasn't been, while the details of the test planning in terms of content and requirements traceability are thorough, no indication of test sequence (e.g. in the schedule) is given. Consequently, it isn't possible to assess feasibility. | 1) Please clarify what testing has already been done and report results | Major
DAVS-6 | Bristol SEDS CDR Report | General | Test failure planning | a) Although it is excellent to have "failure planning", the presentation of this against every test is unusual for an ESA project, since this ends up being "design by test" and opposed to the general idea of the CDR. (Note - this approach isn't *wrong*, but since it is unusual, it needs some explanation) b) Many of the mitigations are significant, "e.g. mass requirement exceedance leading to redesign of structure" and may not be able to be performed in the time between test and delivery (see DAVS-5) c) Many of the mitigations can, and therefore should be, designed in from the start (e.g. lubrication of C rails). d) There is no assessment from the project team which failures are more likely than others since they are all presented at the same level. | Either a) Be up front about adoption of a "fail fast" strategy, and plan enough time into the schedule to allow multiple failures. B) More usually : take those items that can be already designed in, into the design. Present the remainder as risks in section 9.2, since there is a known mechanism for handling risk likelihood/severity which allows evaluation of which ones need particular tracking. | Major
DAVS-7 | Bristol SEDS CDR Report | s5.1.1 / Fig 7 | Wired communication | "The WiFi link can be used ...to send commands in case the primary communication system fails." It isn't clear from figure 7 whether fully wired control/communication can be achieved. Although the Pi3 has an ethernet connection, does your software allow fully wired control of the drivetrain, or is Wifi the backup for 433MHz? Is that a sensible backup? What was your experience here in 2017? (e.g. congested wifi) | Some discussion is required; e.g. during CDR presentation. | Major
DAVS-8 | Bristol SEDS CDR Report | s6.4 | No test ID | No test ID provided. | Update table. | minor
DAVS-9 | Bristol SEDS CDR Report | s7.2 | Adapter plate design | 1) Which is the vibration axis you will be shaking on? (requirement D3) 2) The input shaker load will be coming from the centre 6 bolts, and transmitting out to the 4 corner plates. There is significant mass in the acrylic plate that will not function to improve the stiffness of the plate (depending on the axis chosen) 3) Why only use 6 holes? Why not maximise the number of holes you bolt down onto? | Consider optimising the adapter plate to stiffen in the shaken direction | major
DAVS-10 | Bristol SEDS CDR Report | s7.3 | Bolts for vibration | All bolted joints are usually staked (i.e. have a small amount of glue at the head) to try to help prevent wind-out during random. | For joints that will not need disassembly during test, consider staking the joint. | major
DAVS-11 | Bristol SEDS CDR Report | s7.3 | Test failure planning (2) | Specific examples of generic issue from DAVS-6: "Redesign plate with smaller dimensions" is not realistic - the plate should be toleranced not to exceed the dimensions during manufacture in the first place. Etc. | As per DAVS-6 | minor
AG-1 | Bristol SEDS CDR Report | N/A | User Manual | One of the objectives for the CDR is a release of the user manual detailing rover operation | release document | Minor
AG-2 | Bristol SEDS CDR Report | N/A | Flight hardware / software manufacturing, assembly and testing plans | One of the objectives for the CDR is a release of the Flight hardware / software manufacturing, assembly and testing plans | release document | Minor
