Biskitman/Olympus-Rover/Funding.xlsx

Project Olympus Rover Funding
 | Final |  |  |  |  | Prototype
 | Electronics |  |  |  |  | Electronics
 | Item | Link | Cost | Justification |  | Item | Link | Cost | Justification
 | Raspberry Pi 4 | https://www.okdo.com/p/raspberry-pi-4-model-b-4g/ | £54.00 | Need a good one for AI | 3 | Cameras | https://www.amazon.co.uk/Pieces-Megapixels-Sensor-Compatible-Raspberry/dp/B07ZZ2K7WP | £12.00 | For image recognition, seeing where the crane is
 | Arduino | https://www.amazon.co.uk/ELEGOO-Board-ATmega328P-ATMEGA16U2-Cable/dp/B01EWOE0UU | £8.00 | Needed for controlling the motors etc |  |  | https://www.amazon.co.uk/Raspberry-Pi-1080p-Camera-Module/dp/B01ER2SKFS | £24.00
3 | Raspberry Pi Cameras | https://www.amazon.co.uk/Pieces-Megapixels-Sensor-Compatible-Raspberry/dp/B07ZZ2K7WP | £12.00 | For image recognition, seeing where the crane is | 2 | Motors | https://www.amazon.co.uk/Sourcingmap-10kg-cm-Reversible-Turbine-Electric/dp/B071YLFWPS | £52 | For getting over big rocks with caterpillar tracks
 |  | https://www.amazon.co.uk/Raspberry-Pi-1080p-Camera-Module/dp/B01ER2SKFS | £24.00 |  | 2 | Stepper Motors | https://www.amazon.co.uk/Stepper-13N-cm-Holding-Printer-craftsman168/dp/B07H5C5943 | £22.00 | For the crane system (3d printer like)
2-4 | High Torque motors | https://www.amazon.co.uk/Sourcingmap-10kg-cm-Reversible-Turbine-Electric/dp/B071YLFWPS | £52 or £104 | For getting over big rocks with caterpillar tracks |  | Battery | https://www.amazon.co.uk/TalentCell-Rechargeable-11000mAh-20000mAh-Portable/dp/B06Y5G3C8Z | £57.00 | For power, need to find a lithium polymer not on amazon
2 | Stepper Motors | https://www.amazon.co.uk/Stepper-13N-cm-Holding-Printer-craftsman168/dp/B07H5C5943 | £22.00 | For the crane system (3d printer like)
 | Motor Driver
 | Battery | https://www.amazon.co.uk/TalentCell-Rechargeable-11000mAh-20000mAh-Portable/dp/B06Y5G3C8Z | £57.00 | For power, need to find a lithium polymer not on amazon
2 | Servo | https://www.amazon.co.uk/MoPei-MG996R-Servo-Digital-Helicopter/dp/B06XR571YC | £13.00 | For activating things such as sample retrieval
 | Step down voltage circuit
 | Wireless components
 | Sensors
 | Materials |  |  |  |  | Materials
 | Item | Link | Cost | Justification |  | Item | Link | Cost | Justification
 | Aluminium Extrusion | https://www.amazon.co.uk/Tenlacum-Aluminium-Extrusion-Profiles-20x20mm/dp/B07YNQPSR1 | £20.00 | For the body |  | Aluminium Extrusion | https://www.amazon.co.uk/Tenlacum-Aluminium-Extrusion-Profiles-20x20mm/dp/B07YNQPSR1 | £20.00 | For the body
 | Metal Rods |  |  |  |  | Caterpillar Tracks | https://www.amazon.co.uk/TSSS-Robot-Chassis-Arduino-Raspberry/dp/B07C12DZS1 | £33.00 | For moving
 | ABS/PLA |  |  |  |  | Springs | https://www.amazon.co.uk/Absorber-Aluminum-Control-Upgrade-Accessories/dp/B07L5DT2SM | £12.00 | for shock absorbing, on the motor mounts
 | Panels
 | Caterpillar Tracks | https://www.amazon.co.uk/TSSS-Robot-Chassis-Arduino-Raspberry/dp/B07C12DZS1 | £33.00 | For moving
 | Springs | https://www.amazon.co.uk/Absorber-Aluminum-Control-Upgrade-Accessories/dp/B07L5DT2SM | £12.00 | for shock absorbing, on the motor mounts |  |  | Total: | £232.00
 |  | Total: | £255.00
