Biskitman/Olympus-Rover/CAD/Second Solidworks Attempt/CDR/Practice/Unrelated/Tutor.SLDASM

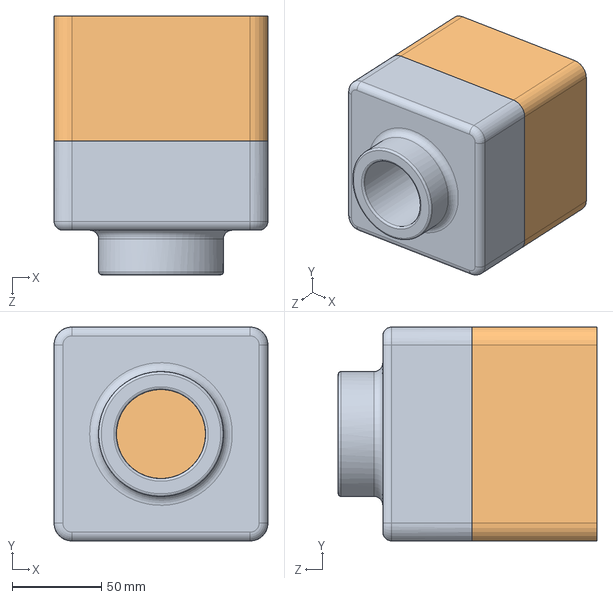
[picture p33: CAD file, 2020-06-02]
CAD/Second Solidworks Attempt/CDR/Practice/Unrelated/Tutor.SLDASM
120.0 x 120.0 x 145.0 mm
Tutor1
Tutor2
