Biskitman/Olympus-Rover/CAD/Second Solidworks Attempt/CDR/Practice/Rod_Assembly_Cheat.SLDPRT

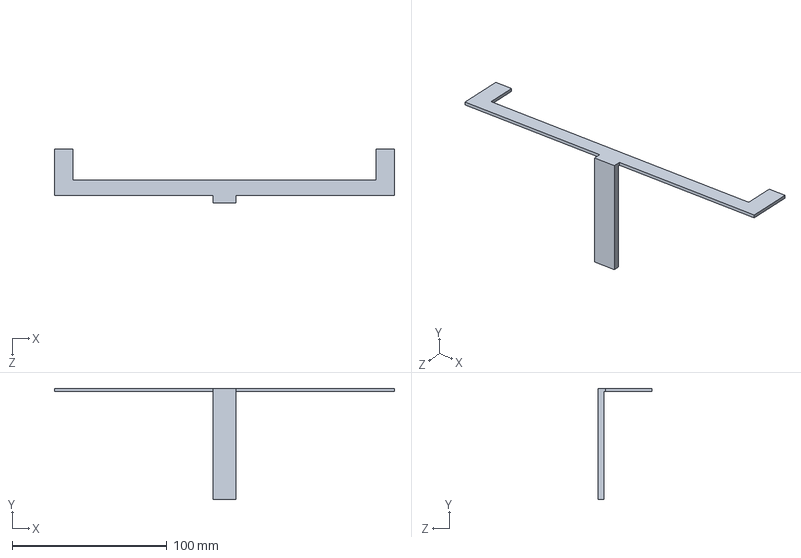
[picture p34: CAD file, 2020-06-02]
CAD/Second Solidworks Attempt/CDR/Practice/Rod_Assembly_Cheat.SLDPRT
220.0 x 72.0 x 35.0 mm
