Biskitman/Olympus-Rover/CAD/Second Solidworks Attempt/CDR/Final Parts/Wheel_Assembly.SLDASM

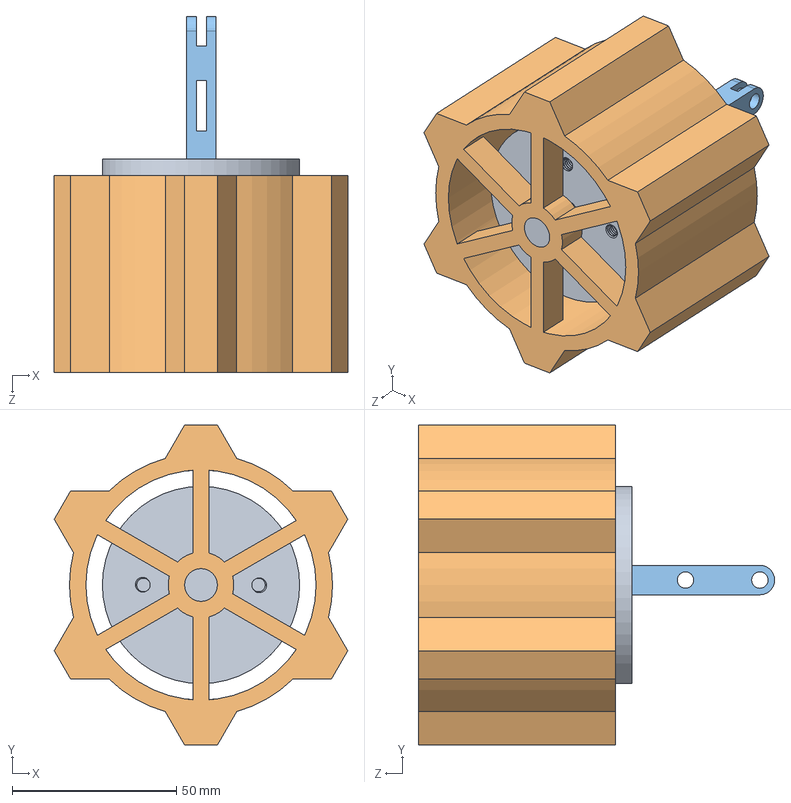
[picture p35: CAD file, 2020-06-02]
CAD/Second Solidworks Attempt/CDR/Final Parts/Wheel_Assembly.SLDASM
89.3 x 97.3 x 108.4 mm
Motor
Wheel2
RoverBody_to_Motor
