Biskitman/Olympus-Rover/CAD/Second Solidworks Attempt/Motor_in_Mount.SLDASM

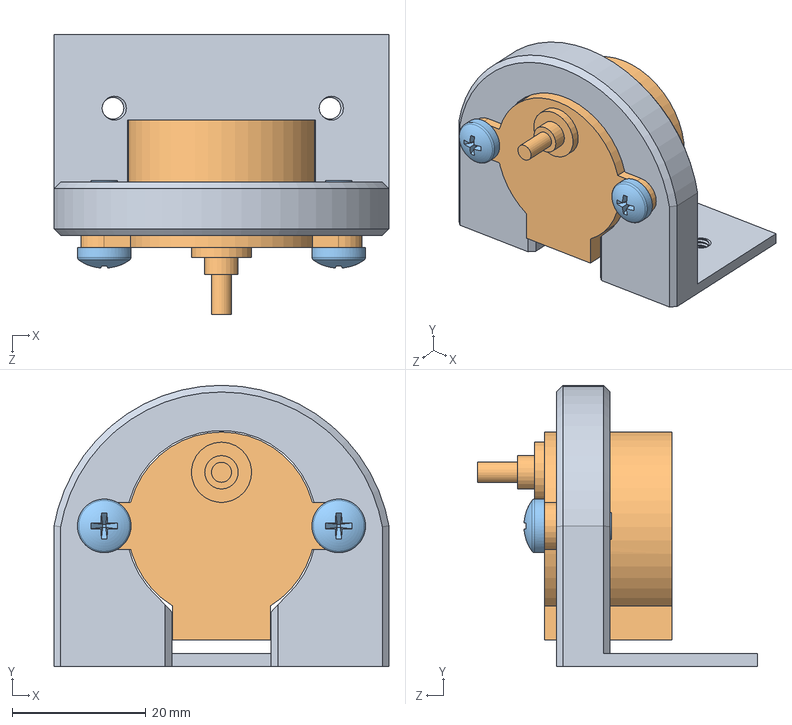
[picture p36: CAD file, 2020-06-02]
CAD/Second Solidworks Attempt/Motor_in_Mount.SLDASM
50.0 x 42.0 x 41.8 mm
Motor_Adapter_Plate
Stepper_Motor
pan cross head_am x 2
