Biskitman/Olympus-Rover/CAD/Second Solidworks Attempt/CDR/Practice/Bearing_Assembly_Cheat.SLDPRT

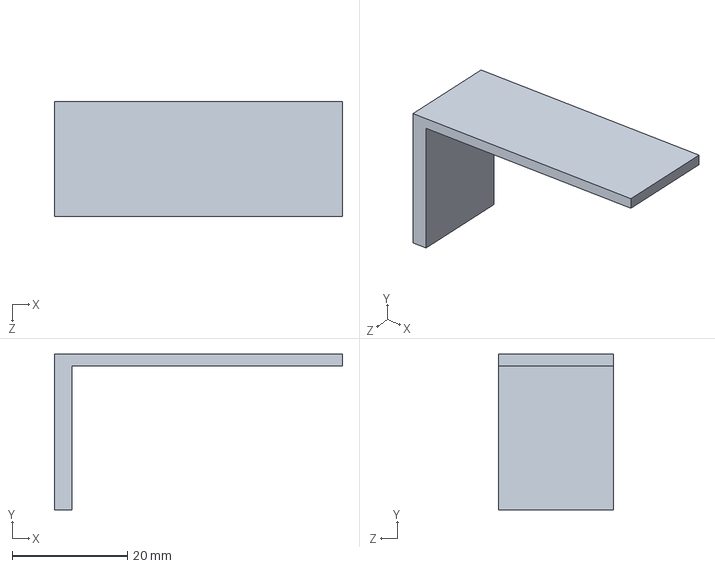
[picture p37: CAD file, 2020-06-02]
CAD/Second Solidworks Attempt/CDR/Practice/Bearing_Assembly_Cheat.SLDPRT
50.0 x 27.0 x 20.0 mm
