Biskitman/Olympus-Rover/CAD/Second Solidworks Attempt/CDR/Practice/First_Motor_Assembly_Cheat.SLDPRT

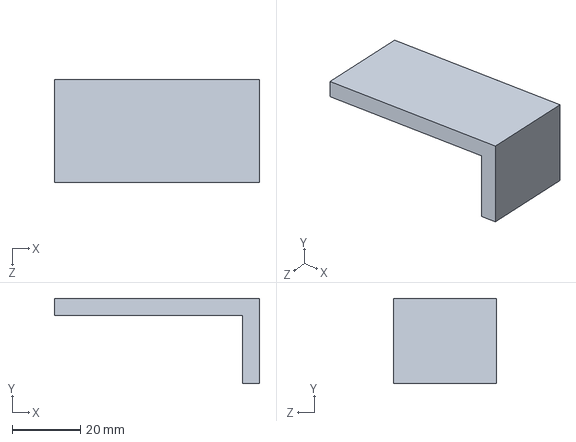
[picture p38: CAD file, 2020-06-02]
CAD/Second Solidworks Attempt/CDR/Practice/First_Motor_Assembly_Cheat.SLDPRT
60.0 x 25.0 x 30.0 mm
