Biskitman/Olympus-Rover/CAD/First Solidworks Attempt/Rover_Body_300x200x100_20mmAE.SLDPRT

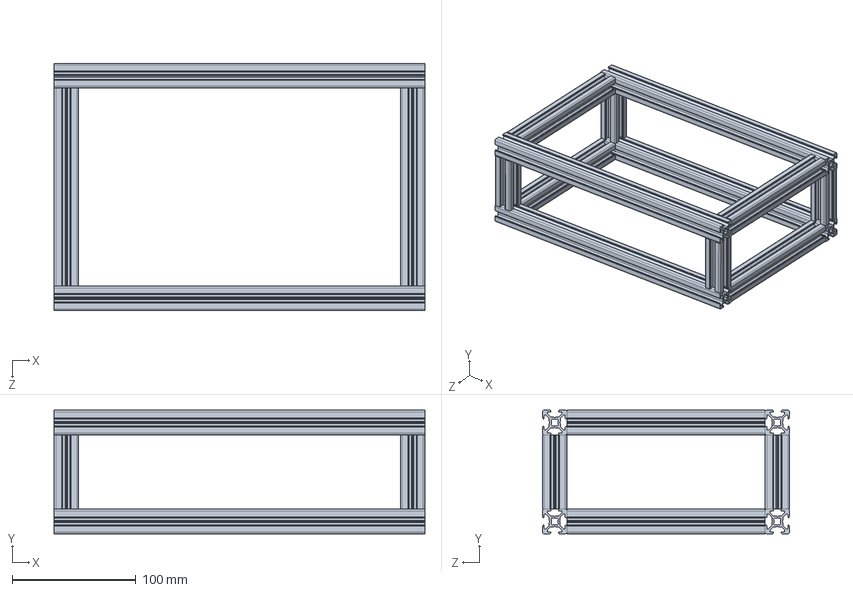
[picture p39: CAD file, 2020-06-02]
CAD/First Solidworks Attempt/Rover_Body_300x200x100_20mmAE.SLDPRT
300.0 x 100.0 x 200.0 mm
