Biskitman/Olympus-Rover/CAD/Second Solidworks Attempt/CDR/Final Parts/Wheel2.SLDPRT

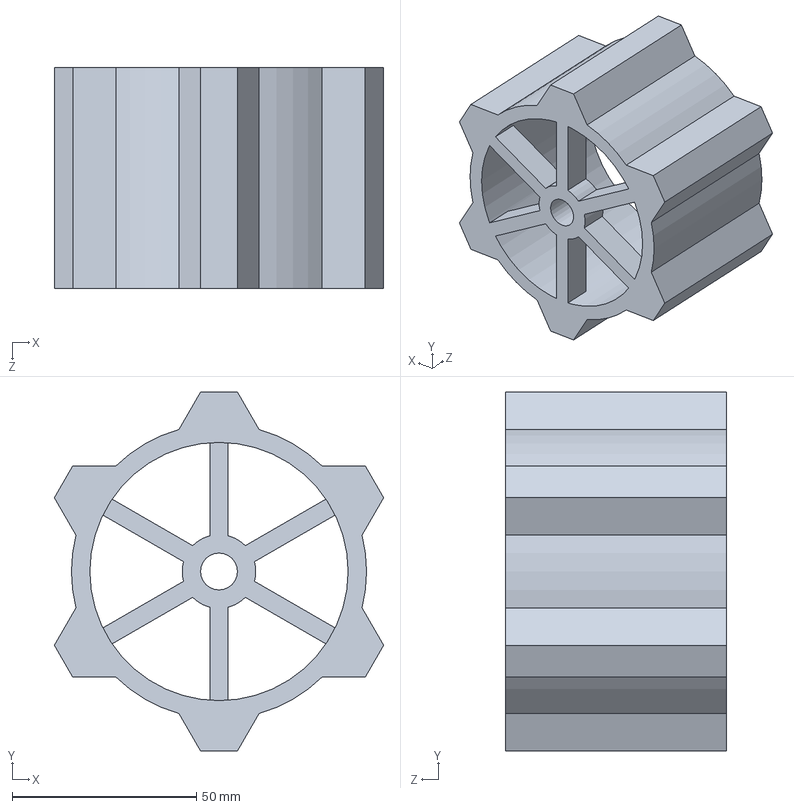
[picture p41: CAD file, 2020-06-02]
CAD/Second Solidworks Attempt/CDR/Final Parts/Wheel2.SLDPRT
89.3 x 97.3 x 60.0 mm
