Biskitman/Olympus-Rover/CAD/Second Solidworks Attempt/CDR/Practice/Crane_Arm.SLDPRT

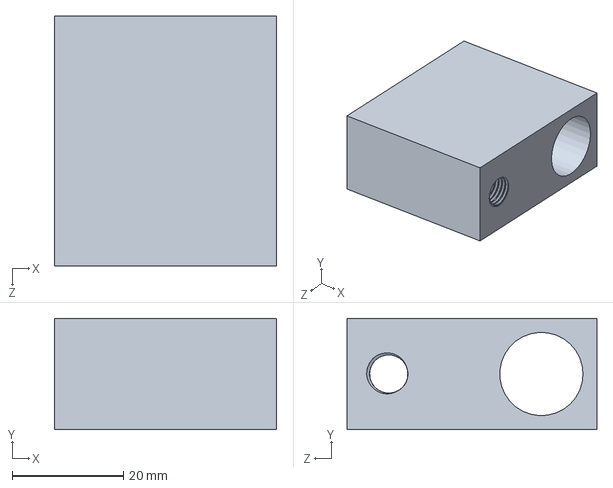
[picture p42: CAD file, 2020-06-02]
CAD/Second Solidworks Attempt/CDR/Practice/Crane_Arm.SLDPRT
40.0 x 20.0 x 45.0 mm
