Biskitman/Olympus-Rover/CAD/Second Solidworks Attempt/Sample.SLDPRT

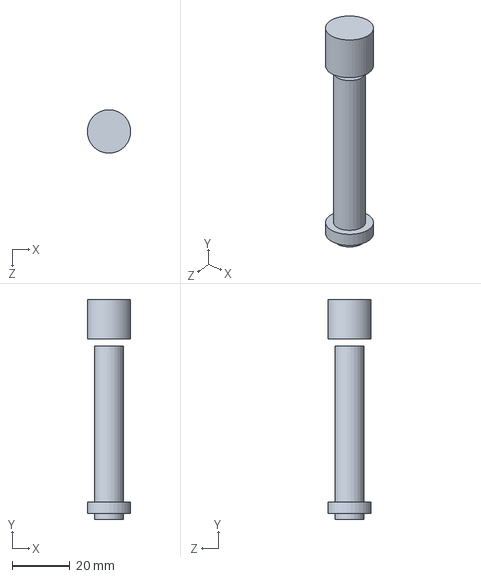
[picture p43: CAD file, 2020-06-02]
CAD/Second Solidworks Attempt/Sample.SLDPRT
15.0 x 76.1 x 15.0 mm
