Biskitman/Olympus-Rover/CAD/Second Solidworks Attempt/Aluminium_Extrusion.SLDPRT

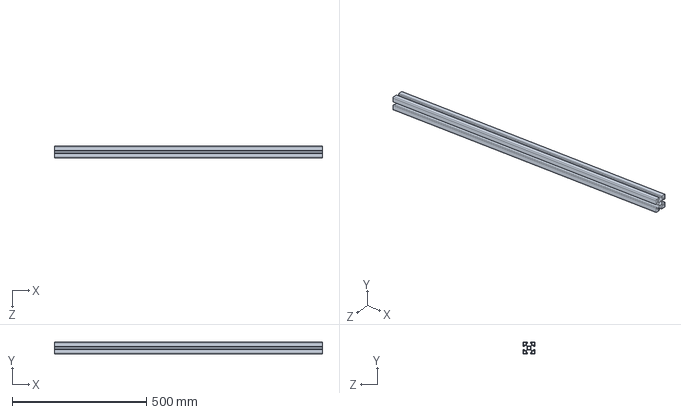
[picture p44: CAD file, 2020-06-02]
CAD/Second Solidworks Attempt/Aluminium_Extrusion.SLDPRT
1000.0 x 45.0 x 45.0 mm
