Biskitman/Olympus-Rover/CAD/Second Solidworks Attempt/CDR/Final Parts/Crane/Rod.SLDPRT

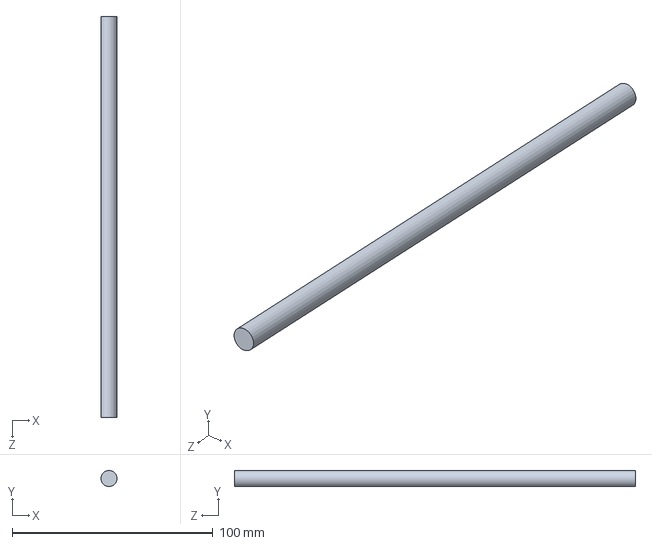
[picture p45: CAD file, 2020-06-02]
CAD/Second Solidworks Attempt/CDR/Final Parts/Crane/Rod.SLDPRT
8.00 x 8.00 x 200.0 mm
