Biskitman/Olympus-Rover/CAD/Second Solidworks Attempt/CDR/Final Parts/Vibration Interface Plate.SLDPRT

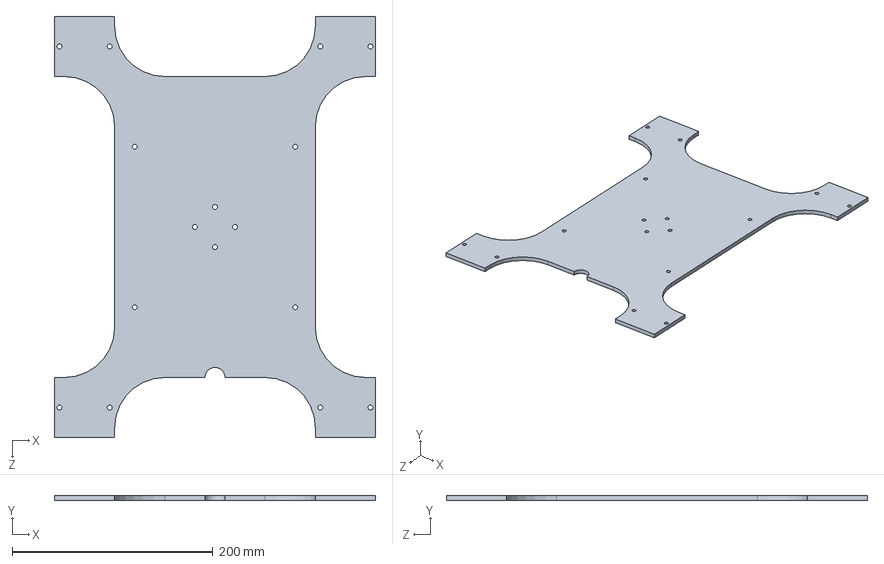
[picture p46: CAD file, 2020-06-02]
CAD/Second Solidworks Attempt/CDR/Final Parts/Vibration Interface Plate.SLDPRT
320.0 x 5.00 x 420.0 mm
