Biskitman/Olympus-Rover/CAD/Second Solidworks Attempt/CDR/Practice/Unrelated/Tutor2.SLDPRT

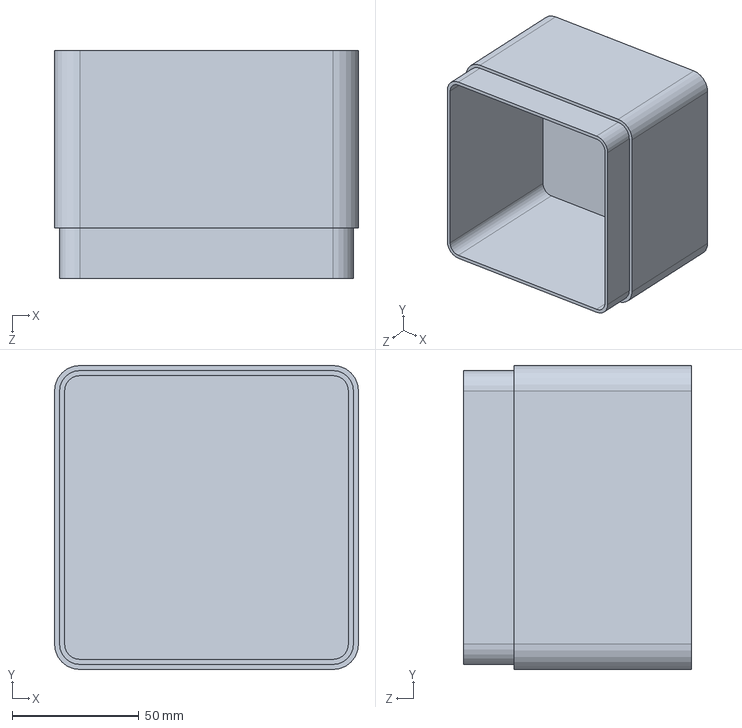
[picture p47: CAD file, 2020-06-02]
CAD/Second Solidworks Attempt/CDR/Practice/Unrelated/Tutor2.SLDPRT
120.0 x 120.0 x 90.0 mm
