Biskitman/Olympus-Rover/CAD/Second Solidworks Attempt/CDR/Final Parts/Battery.SLDPRT

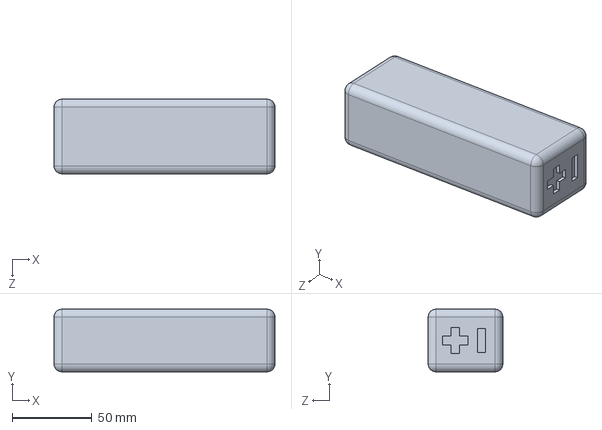
[picture p48: CAD file, 2020-06-02]
CAD/Second Solidworks Attempt/CDR/Final Parts/Battery.SLDPRT
139.0 x 39.5 x 47.0 mm
