Biskitman/Olympus-Rover/CAD/Second Solidworks Attempt/CDR/Final Parts/Crane/Stepper_Motor.SLDPRT

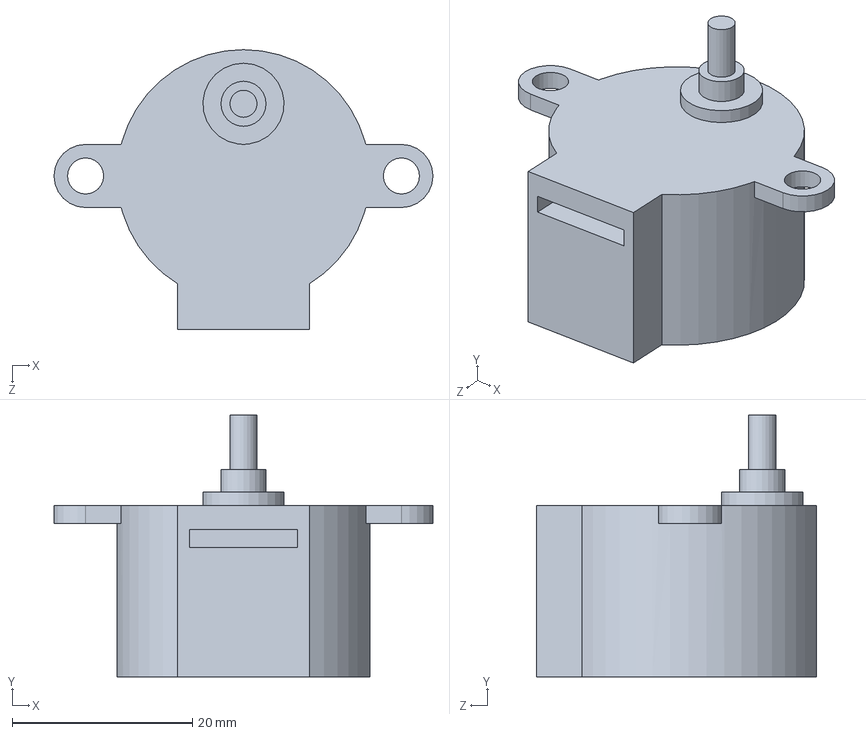
[picture p49: CAD file, 2020-06-02]
CAD/Second Solidworks Attempt/CDR/Final Parts/Crane/Stepper_Motor.SLDPRT
42.0 x 29.0 x 31.0 mm
