Biskitman/Olympus-Rover/CAD/Second Solidworks Attempt/CDR/Practice/Crane_Slider.SLDPRT

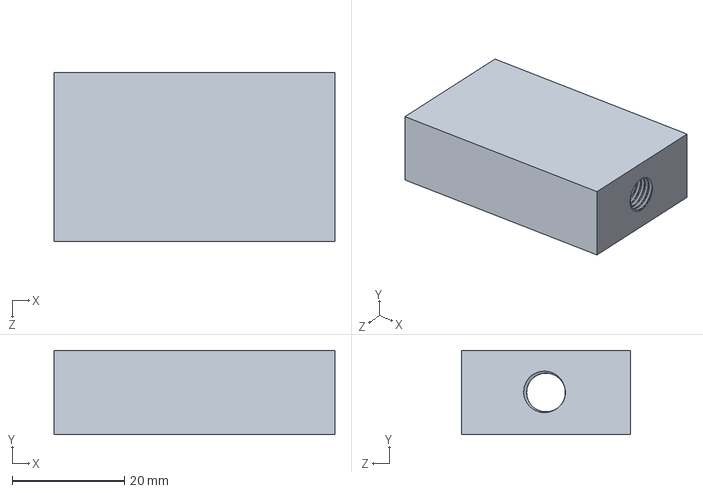
[picture p50: CAD file, 2020-06-02]
CAD/Second Solidworks Attempt/CDR/Practice/Crane_Slider.SLDPRT
50.0 x 15.0 x 30.0 mm
