Biskitman/Olympus-Rover/CAD/Second Solidworks Attempt/CDR/Practice/Unrelated/Tutor1.SLDPRT

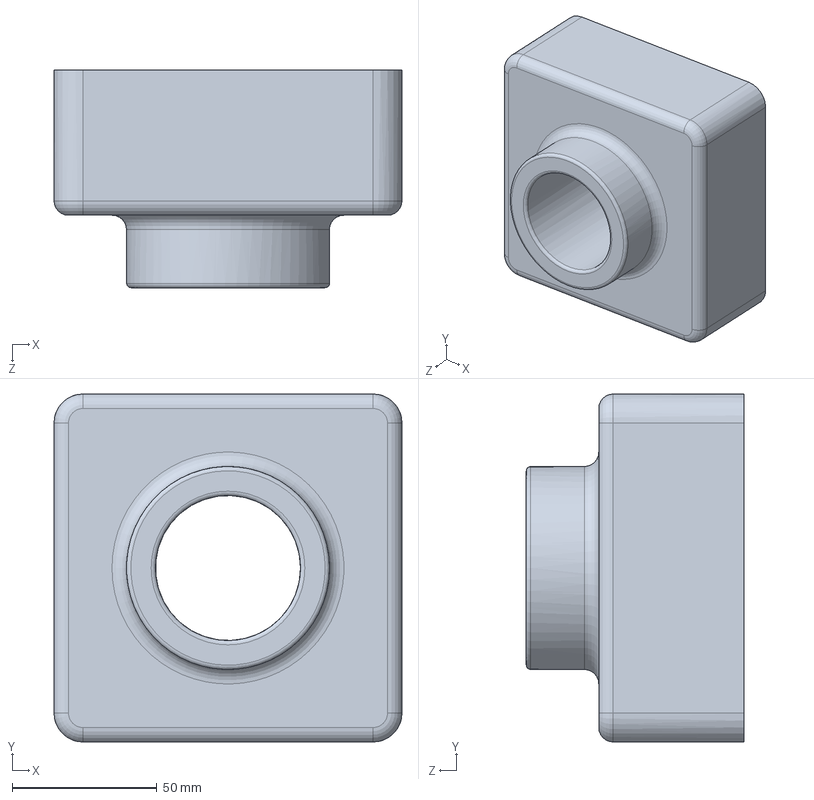
[picture p51: CAD file, 2020-06-02]
CAD/Second Solidworks Attempt/CDR/Practice/Unrelated/Tutor1.SLDPRT
120.0 x 120.0 x 75.0 mm
