Biskitman/Olympus-Rover/CAD/Second Solidworks Attempt/CDR/Practice/Bearing_Holder.SLDPRT

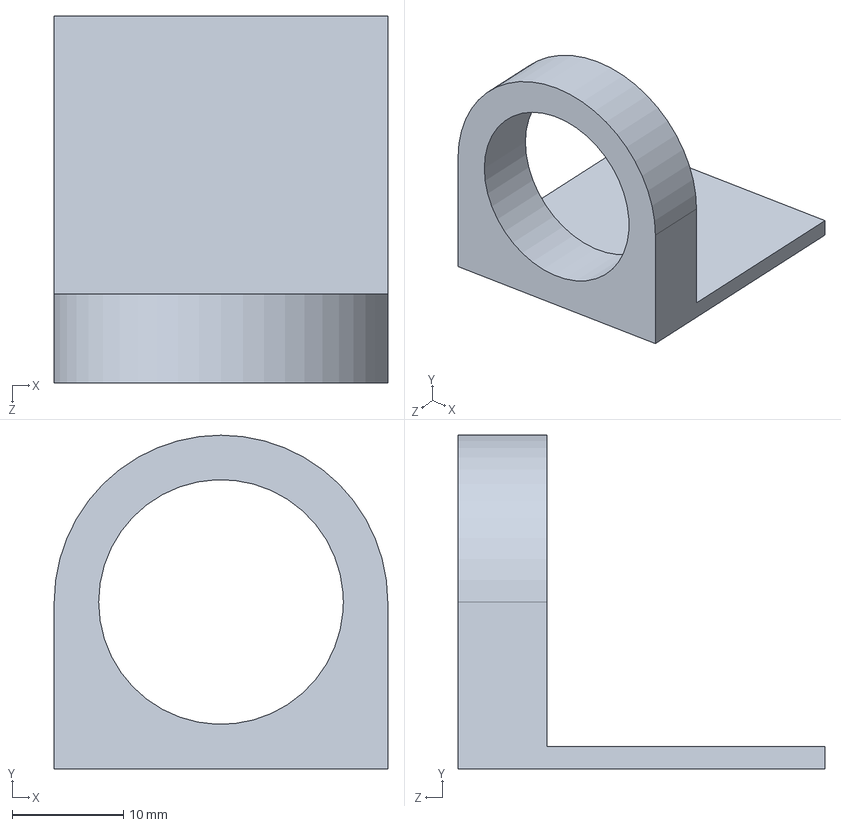
[picture p52: CAD file, 2020-06-02]
CAD/Second Solidworks Attempt/CDR/Practice/Bearing_Holder.SLDPRT
30.0 x 30.0 x 33.0 mm
