Biskitman/Olympus-Rover/CAD/Second Solidworks Attempt/CDR/Practice/Unrelated/Pressure Plate.SLDPRT

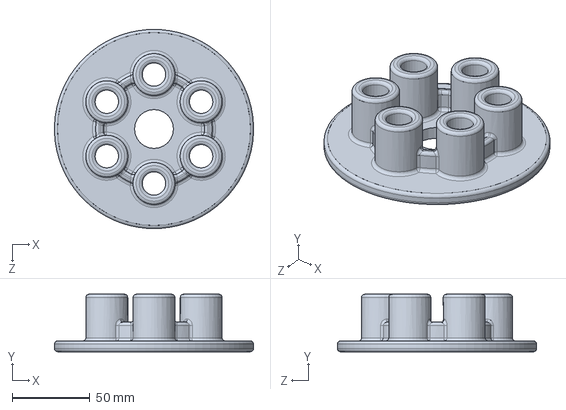
[picture p53: CAD file, 2020-06-02]
CAD/Second Solidworks Attempt/CDR/Practice/Unrelated/Pressure Plate.SLDPRT
127.9 x 37.0 x 128.0 mm
