Biskitman/Olympus-Rover/CAD/Second Solidworks Attempt/CDR/Final Parts/Crane/Motor_Adapter_Plate.SLDPRT

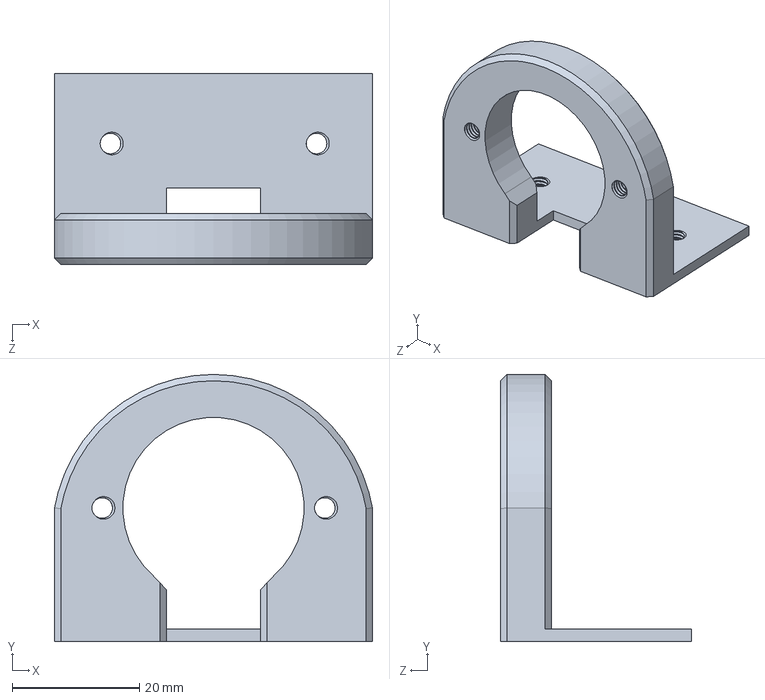
[picture p54: CAD file, 2020-06-02]
CAD/Second Solidworks Attempt/CDR/Final Parts/Crane/Motor_Adapter_Plate.SLDPRT
50.0 x 42.0 x 30.0 mm
