Biskitman/Olympus-Rover/CAD/Second Solidworks Attempt/CDR/Final Parts/Rover_Body_400x300x150.SLDPRT

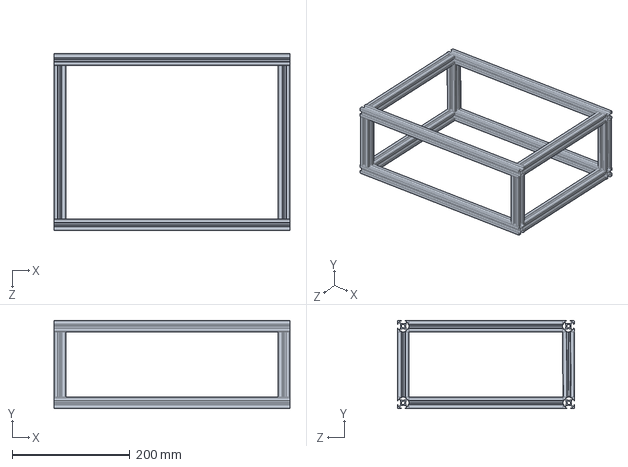
[picture p55: CAD file, 2020-06-02]
CAD/Second Solidworks Attempt/CDR/Final Parts/Rover_Body_400x300x150.SLDPRT
400.0 x 150.0 x 300.8 mm
