Biskitman/Olympus-Rover/CAD/Second Solidworks Attempt/CDR/Practice/Rod_Mount.SLDPRT

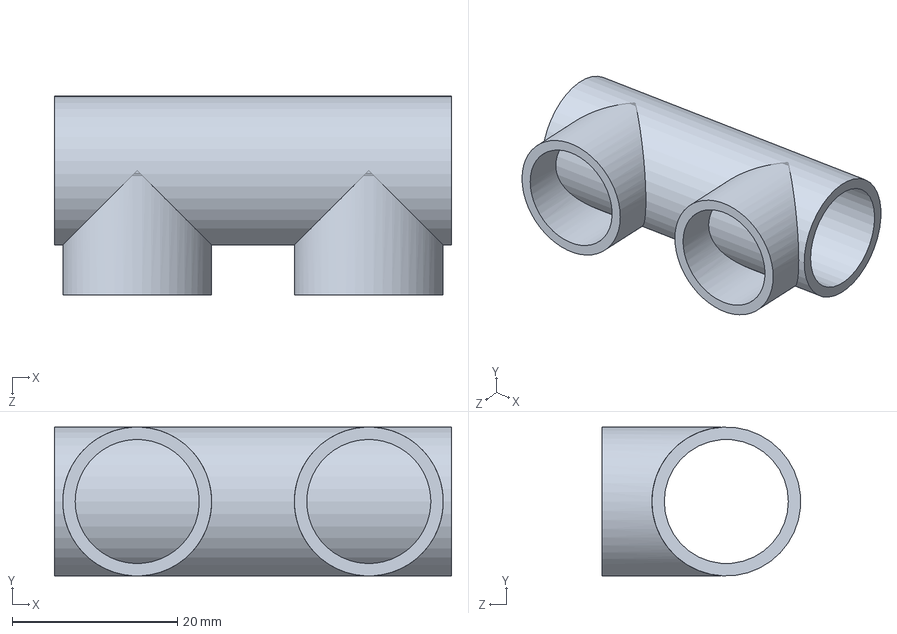
[picture p56: CAD file, 2020-06-02]
CAD/Second Solidworks Attempt/CDR/Practice/Rod_Mount.SLDPRT
48.0 x 18.0 x 24.0 mm
