Biskitman/Olympus-Rover/CAD/Second Solidworks Attempt/CDR/Final Parts/Motor.SLDPRT

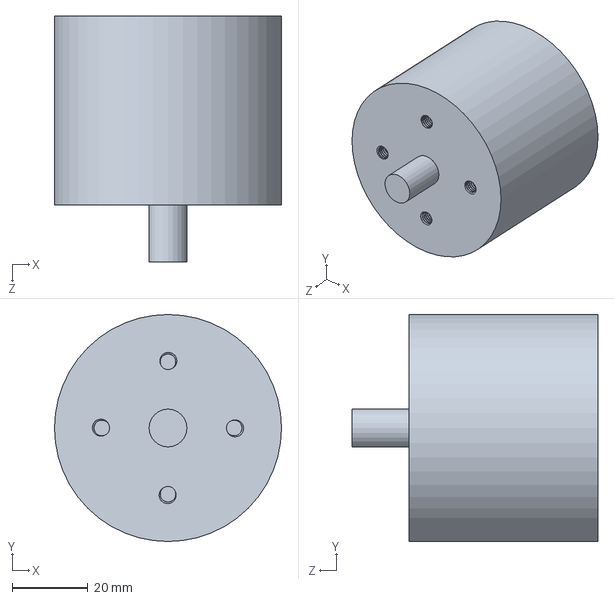
[picture p57: CAD file, 2020-06-02]
CAD/Second Solidworks Attempt/CDR/Final Parts/Motor.SLDPRT
60.0 x 60.0 x 65.0 mm
