Biskitman/Olympus-Rover/CAD/Second Solidworks Attempt/CDR/Practice/Rod_Stopper.SLDPRT

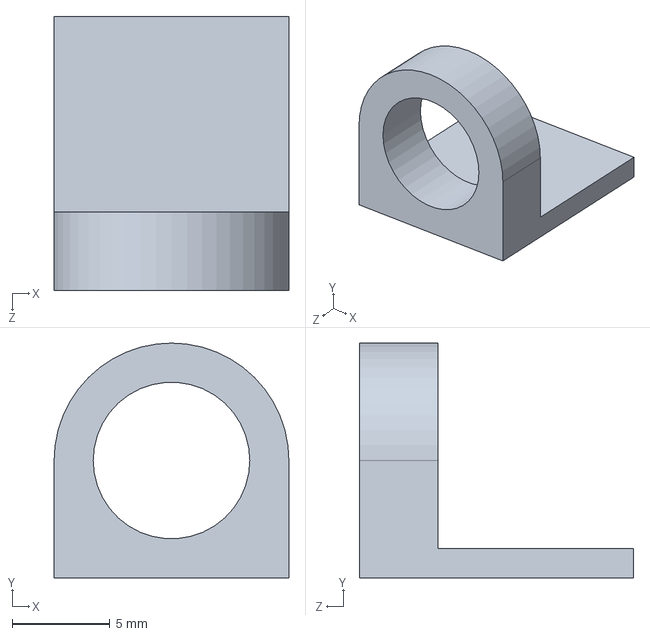
[picture p58: CAD file, 2020-06-02]
CAD/Second Solidworks Attempt/CDR/Practice/Rod_Stopper.SLDPRT
12.0 x 12.0 x 14.0 mm
