Biskitman/Olympus-Rover/CAD/Second Solidworks Attempt/CDR/Final Parts/RoverBody_to_Motor.SLDPRT

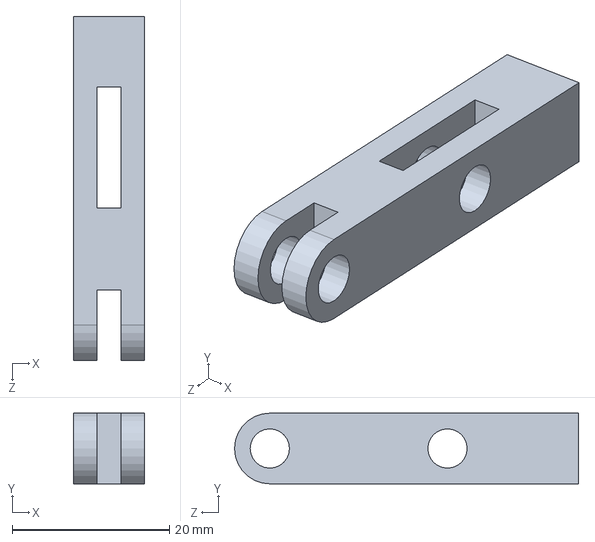
[picture p59: CAD file, 2020-06-02]
CAD/Second Solidworks Attempt/CDR/Final Parts/RoverBody_to_Motor.SLDPRT
9.00 x 9.00 x 43.8 mm
