Biskitman/Olympus-Rover/CAD/Second Solidworks Attempt/CDR/Final Parts/End Cap2.SLDPRT

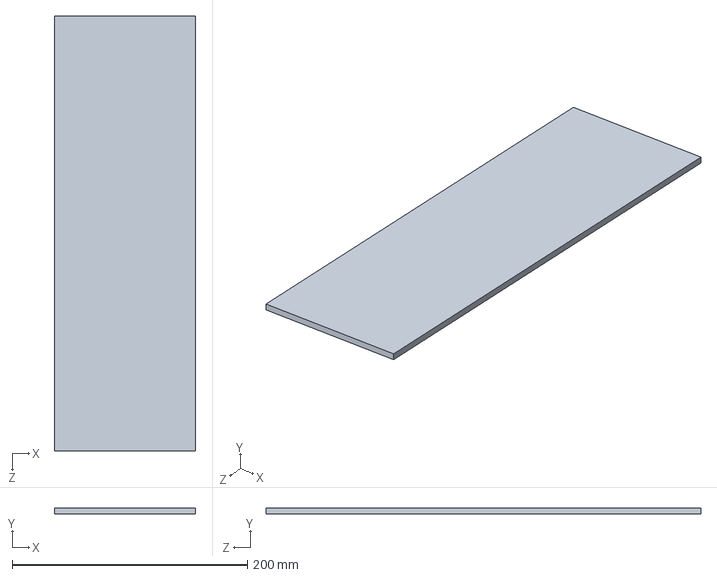
[picture p60: CAD file, 2020-06-02]
CAD/Second Solidworks Attempt/CDR/Final Parts/End Cap2.SLDPRT
120.0 x 5.00 x 370.0 mm
