Biskitman/Olympus-Rover/CAD/Second Solidworks Attempt/CDR/Final Parts/Arduino.SLDPRT

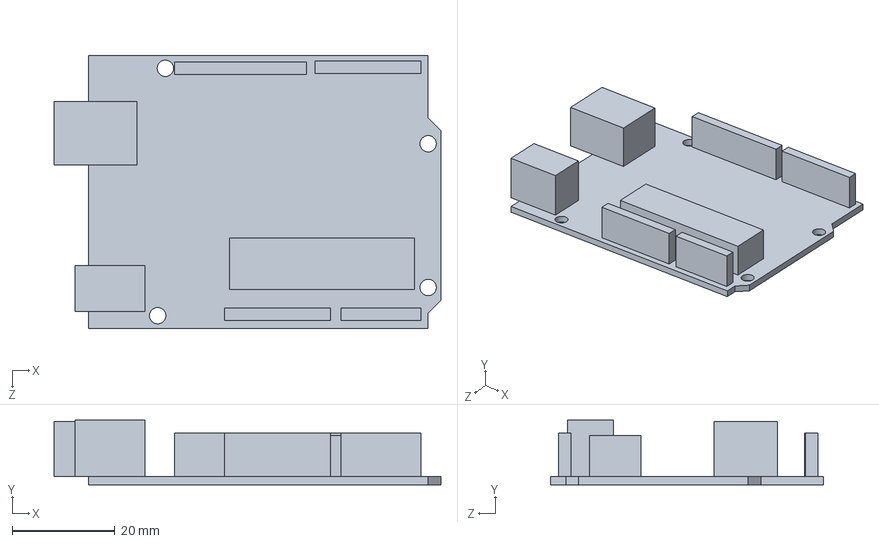
[picture p61: CAD file, 2020-06-02]
CAD/Second Solidworks Attempt/CDR/Final Parts/Arduino.SLDPRT
75.4 x 12.6 x 53.2 mm
