Biskitman/Olympus-Rover/CAD/Second Solidworks Attempt/CDR/Practice/Crane_Guide.SLDPRT

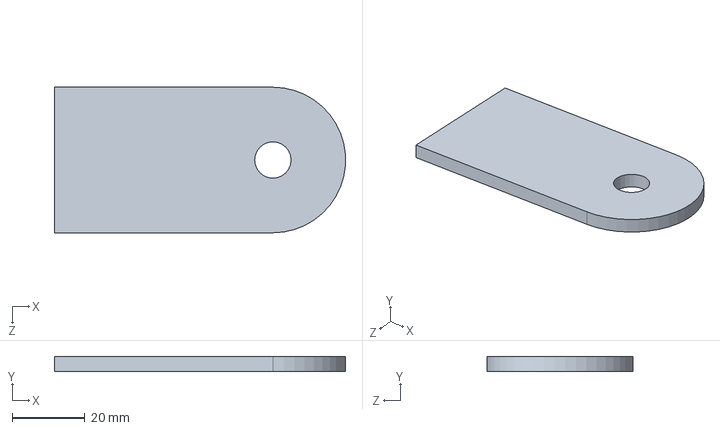
[picture p62: CAD file, 2020-06-02]
CAD/Second Solidworks Attempt/CDR/Practice/Crane_Guide.SLDPRT
79.9 x 4.00 x 40.0 mm
