Biskitman/Olympus-Rover/CAD/Second Solidworks Attempt/CDR/Final Parts/End Cap3.SLDPRT

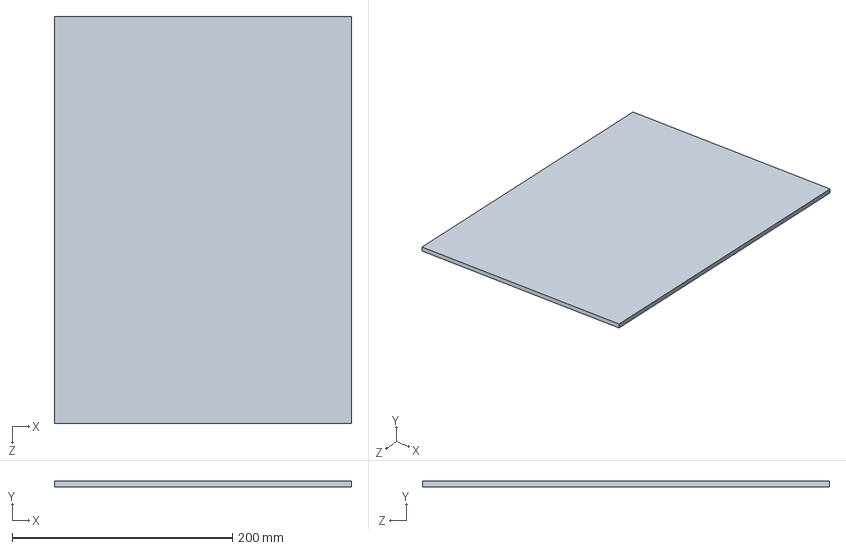
[picture p64: CAD file, 2020-06-02]
CAD/Second Solidworks Attempt/CDR/Final Parts/End Cap3.SLDPRT
270.0 x 5.00 x 370.0 mm
