Biskitman/Olympus-Rover/CAD/Second Solidworks Attempt/CDR/Final Parts/Shock_Absorber.SLDPRT

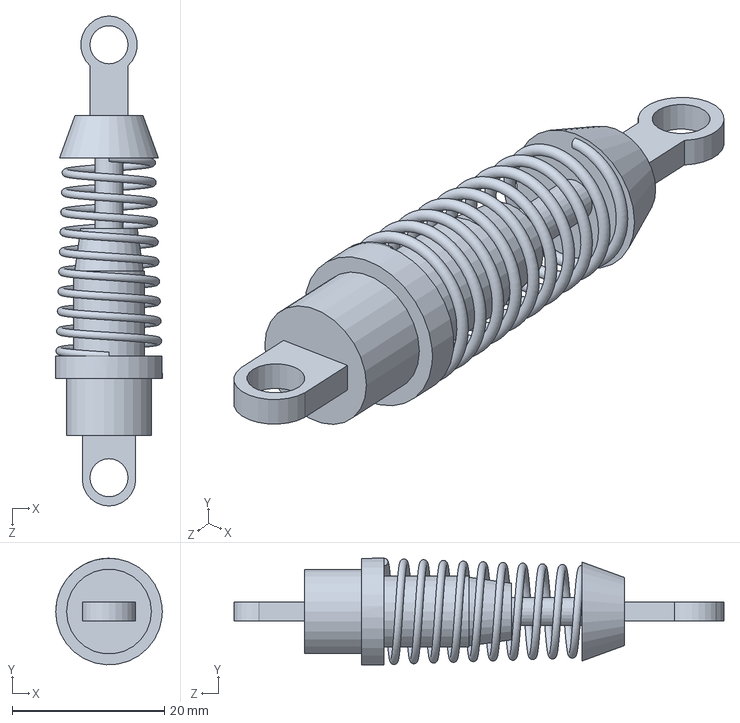
[picture p65: CAD file, 2020-06-02]
CAD/Second Solidworks Attempt/CDR/Final Parts/Shock_Absorber.SLDPRT
14.0 x 14.0 x 64.3 mm
