Biskitman/Olympus-Rover/CAD/Second Solidworks Attempt/CDR/Final Parts/End Cap.SLDPRT

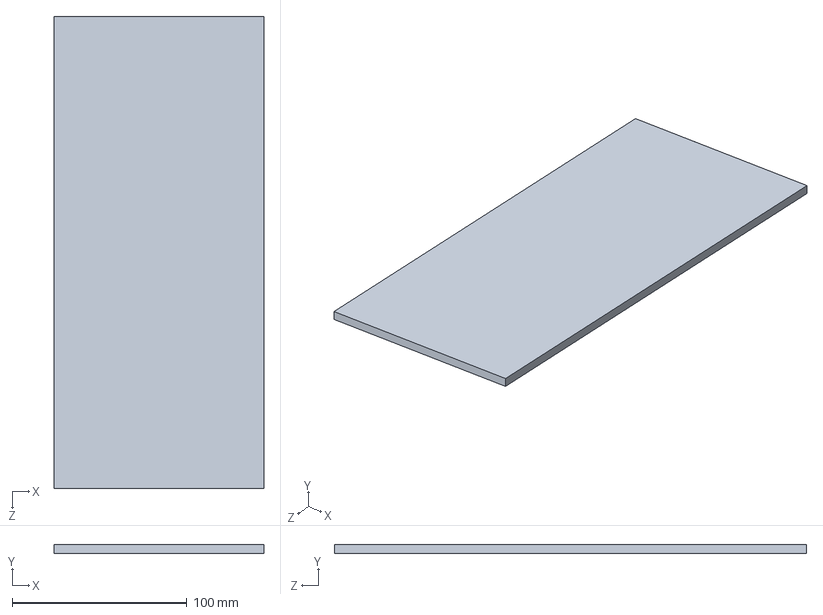
[picture p66: CAD file, 2020-06-02]
CAD/Second Solidworks Attempt/CDR/Final Parts/End Cap.SLDPRT
120.0 x 5.00 x 270.0 mm
