Biskitman/Olympus-Rover/CAD/Second Solidworks Attempt/CDR/Final Parts/Raspberry_Pi_3B.SLDPRT

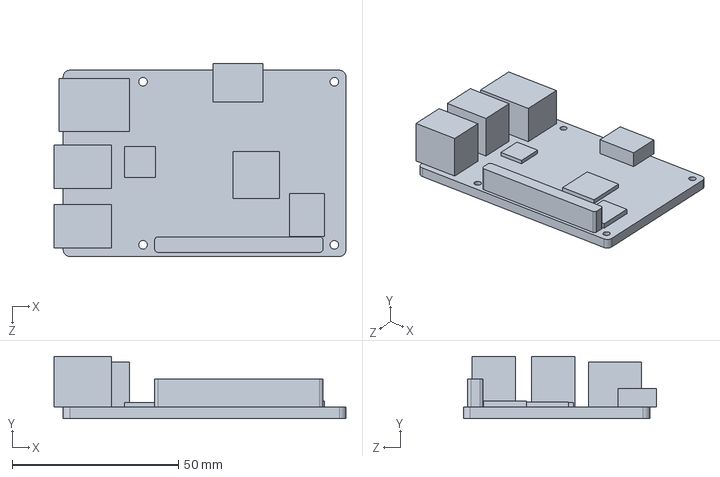
[picture p67: CAD file, 2020-06-02]
CAD/Second Solidworks Attempt/CDR/Final Parts/Raspberry_Pi_3B.SLDPRT
87.8 x 18.8 x 58.0 mm
