Biskitman/Olympus-Rover/CAD/Second Solidworks Attempt/CDR/Final Parts/Wheel.SLDPRT

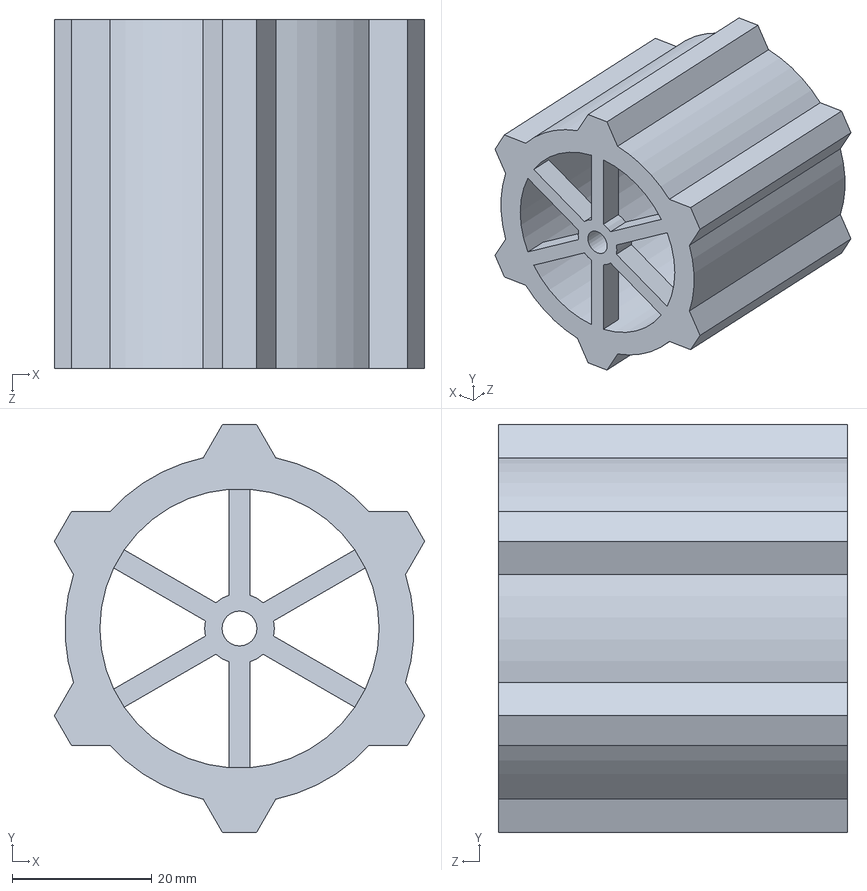
[picture p68: CAD file, 2020-06-02]
CAD/Second Solidworks Attempt/CDR/Final Parts/Wheel.SLDPRT
53.1 x 58.5 x 50.0 mm
