Biskitman/Olympus-Rover/(list of files, cad)

Other CAD files:
CAD/First Solidworks Attempt/Rover_Body_300x200x100.SLDPRT
CAD/Second Solidworks Attempt/Rover_Body_300x200x100_20mmAE.SLDPRT
CAD/First Solidworks Attempt/Rover Body.SLDPRT
CAD/Second Solidworks Attempt/Rover Body.SLDPRT
CAD/Second Solidworks Attempt/CDR/Practice/Crane.SLDPRT
CAD/Second Solidworks Attempt/CDR/Final Parts/Battery_Holder.SLDPRT
CAD/Second Solidworks Attempt/CDR/Final Parts/Rover Body.SLDPRT
CAD/Second Solidworks Attempt/CDR/Final Parts/Crane/Bolt_M8-1.0 x 200.SLDPRT
CAD/Second Solidworks Attempt/CDR/Practice/Unrelated/Nut_Bolt_Assembly_Tutorial.SLDASM
CAD/Second Solidworks Attempt/CDR/Practice/Unrelated/Pressure Plate.SLDDRW
CAD/Second Solidworks Attempt/CDR/Practice/Unrelated/Tutorial_Bolt.SLDPRT
CAD/Second Solidworks Attempt/CDR/Practice/Unrelated/Tutorial_Nut.SLDPRT
